CouchmobileUNSW/couchmobile-electrical/couchmobile-control/rev1/14686-Qwiic_VR_IMU_BN0080-02.jpg

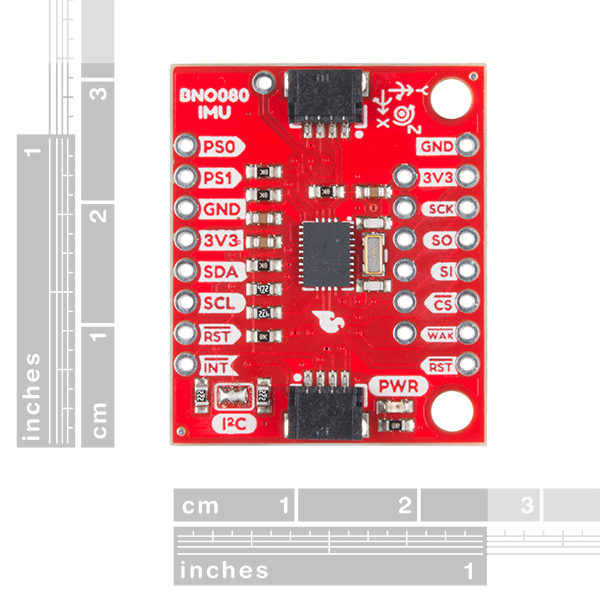
couchmobile-control/rev1/14686-Qwiic_VR_IMU_BN0080-02.jpg
