CouchmobileUNSW/couchmobile-electrical/couchmobile-control/rev1/README.md

TODO for Rev1:

Changes:
MISO, MOSI, SCK need to be made 5V tolerant, or removed
BNO080 footprint needs to be widened by 2.54mm
Traces under RF module should be adjusted slightly so they spend less time under the RF module
Resistor and LED designators for status LEDs should be swapped around in position; ie the LED designator should be facing towards the outside
SO-8 footprint needs to be made smaller
HC74 DIP 14 needs to be made bigger
E_ON should be inverted signal of the signal sent to the HC74 AND gate
