CouchmobileUNSW/couchmobile-electrical/couchmobile-old-couch/couch-int-rc.csv.xlsx

Qty | Value | Device | Package | Parts | Description | Source
1 |  | DIODE-SMB | SMB | D1 | DIODE | w
1 |  | L-USL3216C | 1206 | FB1 | INDUCTOR, American symbol | d
4 |  | LEDCHIP-LED0603 | CHIP-LED0603 | LED6, LED7, LED8, LED9 | LED | w
4 |  | MA02-1 | MOLEX-2 | J2, J20, J21, J22 |  | w
8 |  | MA03-1 | MA03-1 | J6, J9, J10, J11, J24, J25, J26, J27 | PIN HEADER | w
1 |  | MA05-1 | MA05-1 | J8 | PIN HEADER | w
1 | 1.5k | R-US_R0603 | R0603 | R6 | RESISTOR, American symbol | w
14 | 100nF | C-EUC0603 | C0603 | C3, C5, C8, C10, C11, C12, C13, C14, C19, C20, C21, C22, C23, C24 | CAPACITOR, European symbol | w
3 | 10k | R-US_R0603 | R0603 | R2, R66, R67 | RESISTOR, American symbol | w
1 | 10uF | C-EUC0603 | C0603 | C16 | CAPACITOR, European symbol | w
2 | 10uF | C-EUC1206 | C1206 | C9, C30 | CAPACITOR, European symbol | w
1 | 1296-T10 | 1296-T10 | 1296-10 | J18 | 1.27mm SINGLE ROW FEMALE SOCKET | w
1 | 12V rail | LEDCHIPLED_0603 | CHIPLED_0603 | LED4 | LED | w
4 | 150 | R-US_R0603 | R0603 | R18, R33, R40, R54 | RESISTOR, American symbol | w
1 | 15V | ZENER-DIODESOD80C | SOD80C | D2 | Z-Diode | d
2 | 18pF | C-EUC0603 | C0603 | C17, C18 | CAPACITOR, European symbol | w
1 | 1A | SHK20L | SHK20L | F3 | FUSE HOLDER 5 x 20 mm, SH contact, SHH1 Schukat, E1073 Buerklin | w
1 | 1nF | C-EUC0603 | C0603 | C34 | CAPACITOR, European symbol | w
3 | 1uF | C-EUC0603 | C0603 | C1, C2, C25 | CAPACITOR, European symbol | w
5 | 22uF | C-EUC1206 | C1206 | C4, C6, C7, C28, C29 | CAPACITOR, European symbol | w
1 | 25MHz | CRYSTALHC49S | HC49/S | X1 | CRYSTAL | w
1 | 27k | R-US_R0603 | R0603 | R7 | RESISTOR, American symbol | w
1 | 2A | FUSESHK20L | SHK20L | F1 | Fuse | w
1 | 2k | R-US_R0603 | R0603 | R13 | RESISTOR, American symbol | w
1 | 3.3V rail | LEDCHIPLED_0603 | CHIPLED_0603 | LED2 | LED | w
1 | 3.3k | R-US_R0603 | R0603 | R8 | RESISTOR, American symbol | w
2 | 330 | R-US_R0603 | R0603 | R11, R12 | RESISTOR, American symbol | w
1 | 33k | R-US_R0603 | R0603 | R9 | RESISTOR, American symbol | w
6 | 4.7k | R-US_R0603 | R0603 | R22, R25, R27, R39, R44, R50 | RESISTOR, American symbol | w
28 | 470 | R-US_R0603 | R0603 | R19, R20, R21, R23, R24, R26, R28, R34, R35, R36, R38, R41, R42, R46, R47, R48, R49, R55, R56, R57, R58, R59, R60, R61, R62, R63, R64, R65 | RESISTOR, American symbol | w
4 | 49.9 | R-US_R0603 | R0603 | R14, R15, R16, R17 | RESISTOR, American symbol | w
1 | 5.6V | ZENER-DIODESOD80C | SOD80C | D3 | Z-Diode | d
2 | 5.6k | R-US_R0603 | R0603 | R4, R68 | RESISTOR, American symbol | w
1 | 500mA | SHK20L | SHK20L | F2 | FUSE HOLDER 5 x 20 mm, SH contact, SHH1 Schukat, E1073 Buerklin | w
1 | 56k | R-US_R0603 | R0603 | R1 | RESISTOR, American symbol | w
1 | 5V rail | LEDCHIPLED_0603 | CHIPLED_0603 | LED3 | LED | w
1 | 6.8k | R-US_R0603 | R0603 | R10 | RESISTOR, American symbol | w
3 | 680 | R-US_R0603 | R0603 | R5, R37, R43 | RESISTOR, American symbol | w
4 | 75 | R-US_R0603 | R0603 | R29, R30, R31, R32 | RESISTOR, American symbol | w
1 | 82k | R-US_R0603 | R0603 | R3 | RESISTOR, American symbol | w
1 | ASE | ASE | ASE | XO1 | 3.3Vdc CMOS SMD CRYSTAL CLOCK OSCILLATOR | d
1 | BSS123 | BSS123 | SOT23 | Q1 | N-CHANNEL MOS FET | w
1 | BU-SMA-V | BU-SMA-V | BU-SMA-V | J12 | FEMALE SMA CONNECTOR | w
1 | DMP3099L | BSS84 | SOT23 | Q2 | P-CHANNEL MOS FET | d
1 | ENC28J60SS | ENC28J60SS | SSOP-28 | IC5 |  | d
2 | ESD4TPD4F003 | ESD4TPD4F003 | WSON-8 | E1, E2 |  | d
1 | ESTOP | LEDCHIPLED_0603 | CHIPLED_0603 | LED1 | LED | w
1 | Farnell 1864471 (TODO check) | L_USMCSDRH73B | MCSDRH73B | L1 |  | w
1 | LD117AS33TR | LD117AS33TR | SOT223 | IC1 | Low drop fixed and adjustable positive voltage regulators 1 A | w
1 | MA03-1KK | MA03-1KK | MOLEX-3 | J3 |  | w
4 | MA05-1 | MA05-1 | MOLEX-5 | J14, J15, J16, J17 |  | d
1 | Motor power | LEDCHIPLED_0603 | CHIPLED_0603 | LED5 | LED | w
1 | PCBTERM2 | PCBTERM2 | PCBTERM | J4 |  | w
1 | PCBTERM3 | PCBTERM3 | PCBTERM3 | J1 |  | w
1 | PIC32MK0512MCF064 | PIC32MK0512MCF064 | TQFP-64-10 | IC3 |  | d
1 | PIN262409-1 | PIN262409-1 | 62409-1 | J5 | Flachstecker Typ Tyco/Electronics/AMP TAB, FASTON | w
4 | PTC4.7 | R-EU_R0603 | R0603 | R45, R51, R52, R53 | RESISTOR, European symbol | d
1 | RF-LORA-PD | RF-LORA-PD | RF-LORA-DIP | U1 |  | f
1 | RJ45-6L-B | RJ45-6L-B | RJ45-NO-SHIELD | J7 | CORCOM Modular RJ Jacks No Shield | f
1 | TG110-E055N5 | TG110-E055N5 | N5 | T1 | E-Ultra (TM) 10/100BASE-TX SOIC-16 Fast Ethernet Magnetic Modules | f
1 | TPS563209 | TPS563209 | SOT23-6 | IC2 |  | w
1 | USB-MICROB1051330001 | USB-MICROB1051330001 | 1051330001 | J13 |  | d
