CouchmobileUNSW/couchmobile-electrical/couchmobile-old-couch/couch-int-rc-brd.pdf

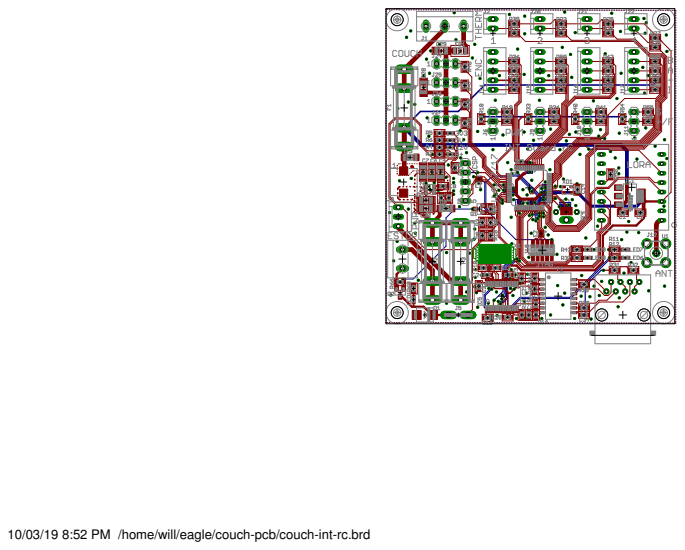
[picture p4: page 1]

10/03/19 8:52 PM /home/will/eagle/couch-pcb/couch-int-rc.brd
