CouchmobileUNSW/couchmobile-electrical/couchmobile-old-couch/couch-int-rc-sch.pdf

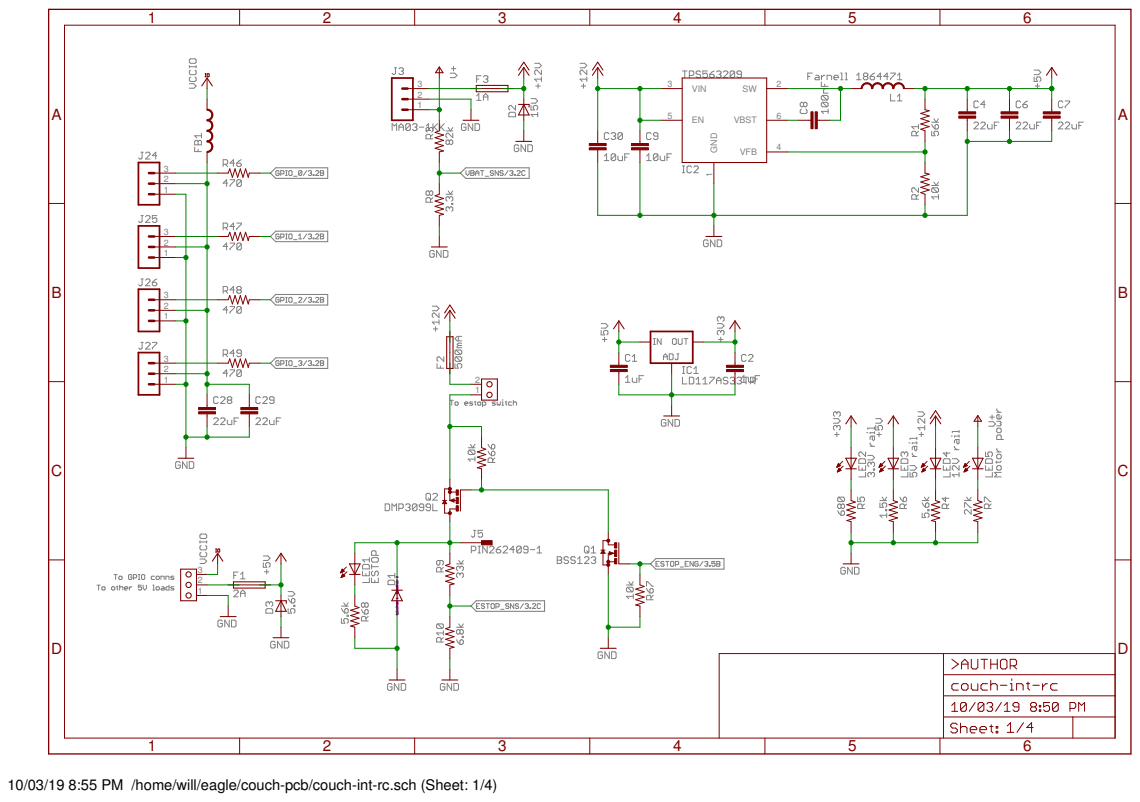
[picture p5: page 1]

10/03/19 8:55 PM /home/will/eagle/couch-pcb/couch-int-rc.sch (Sheet: 1/4)
