CouchmobileUNSW/couchmobile-electrical/couchmobile-old-couch/couch-pwr-rb-brd.pdf

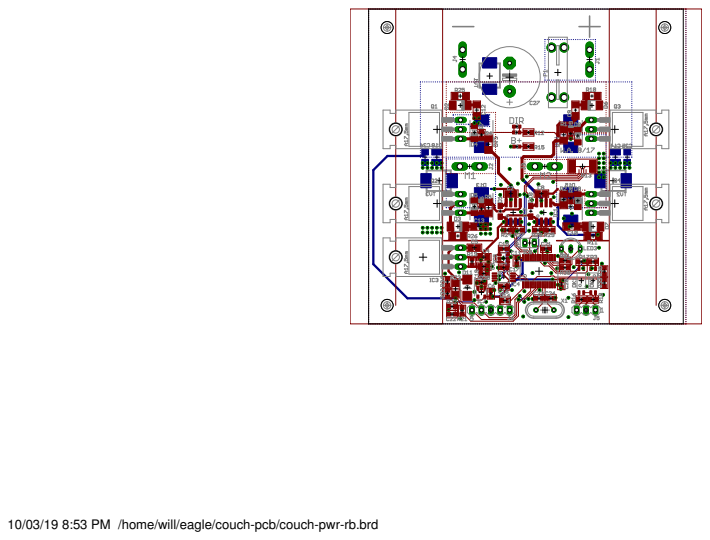
[picture p6: page 1]

10/03/19 8:53 PM /home/will/eagle/couch-pcb/couch-pwr-rb.brd
