CouchmobileUNSW/couchmobile-electrical/couchmobile-old-couch/couch-pwr-rb-sch.pdf

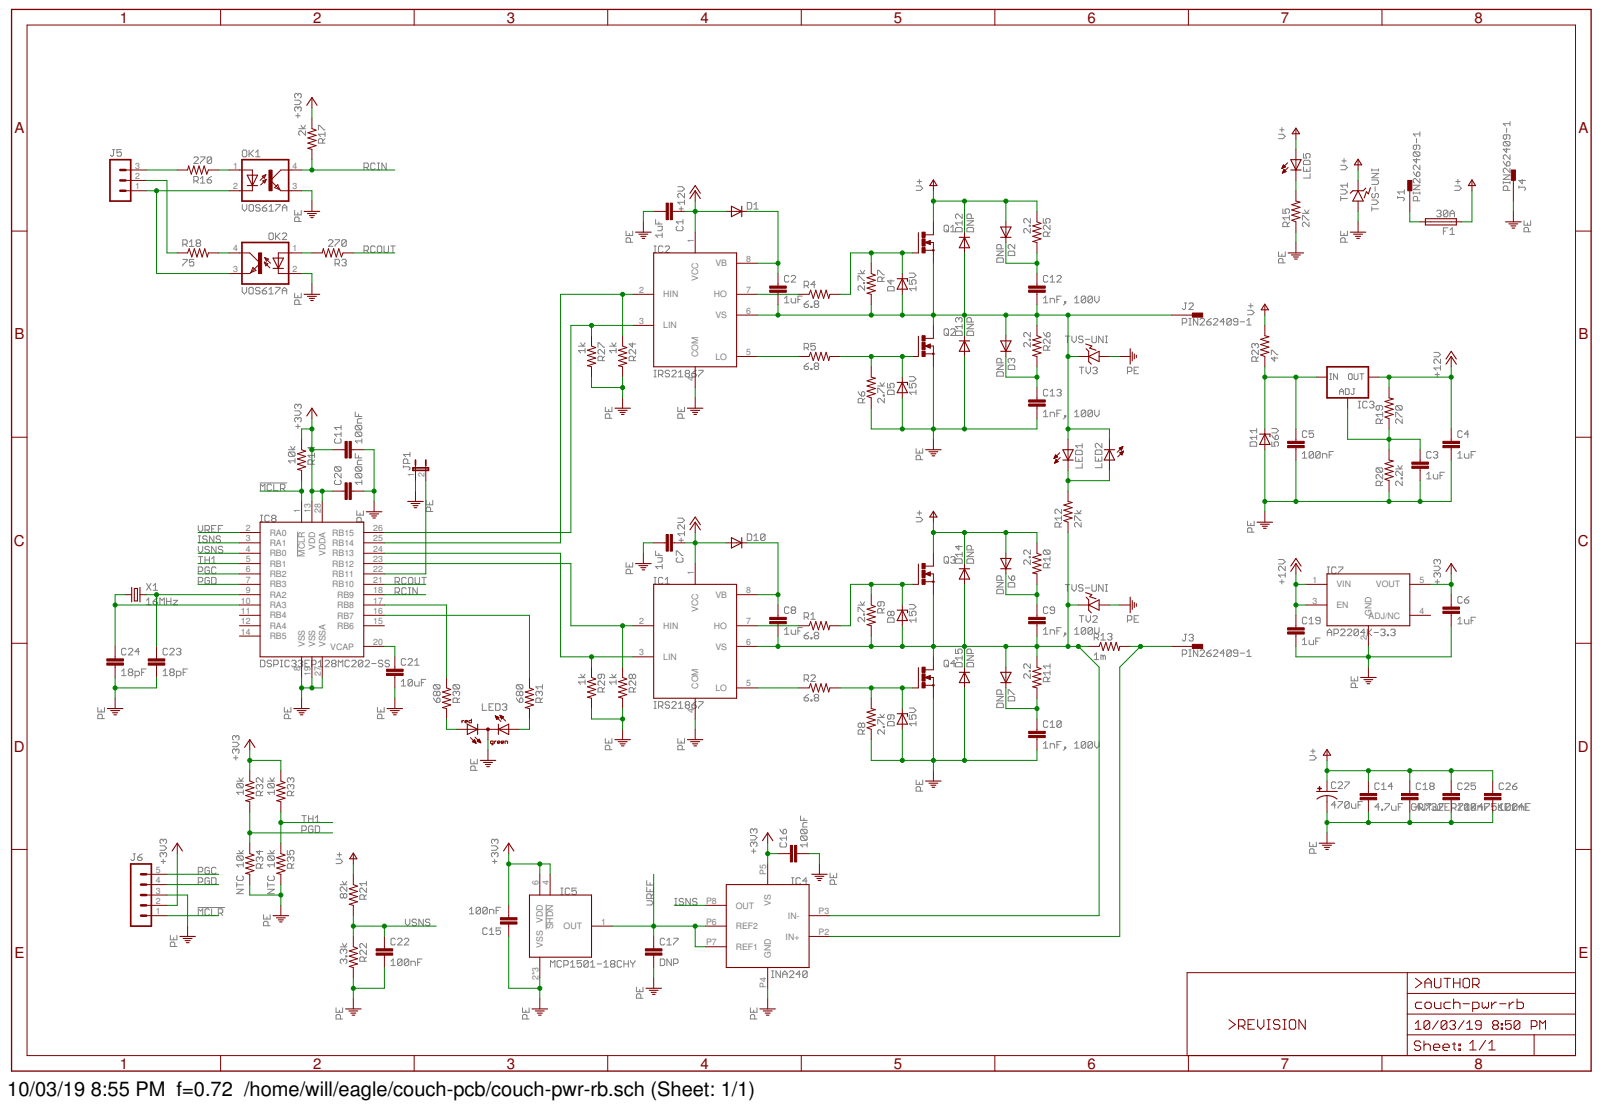
[picture p7: page 1]

10/03/19 8:55 PM f=0.72 /home/will/eagle/couch-pcb/couch-pwr-rb.sch (Sheet: 1/1)
