CouchmobileUNSW/couchmobile-electrical/control pad/control pad.kicad_pcb

## KiCad design control pad/control pad.kicad_pcb (2019-08-29)

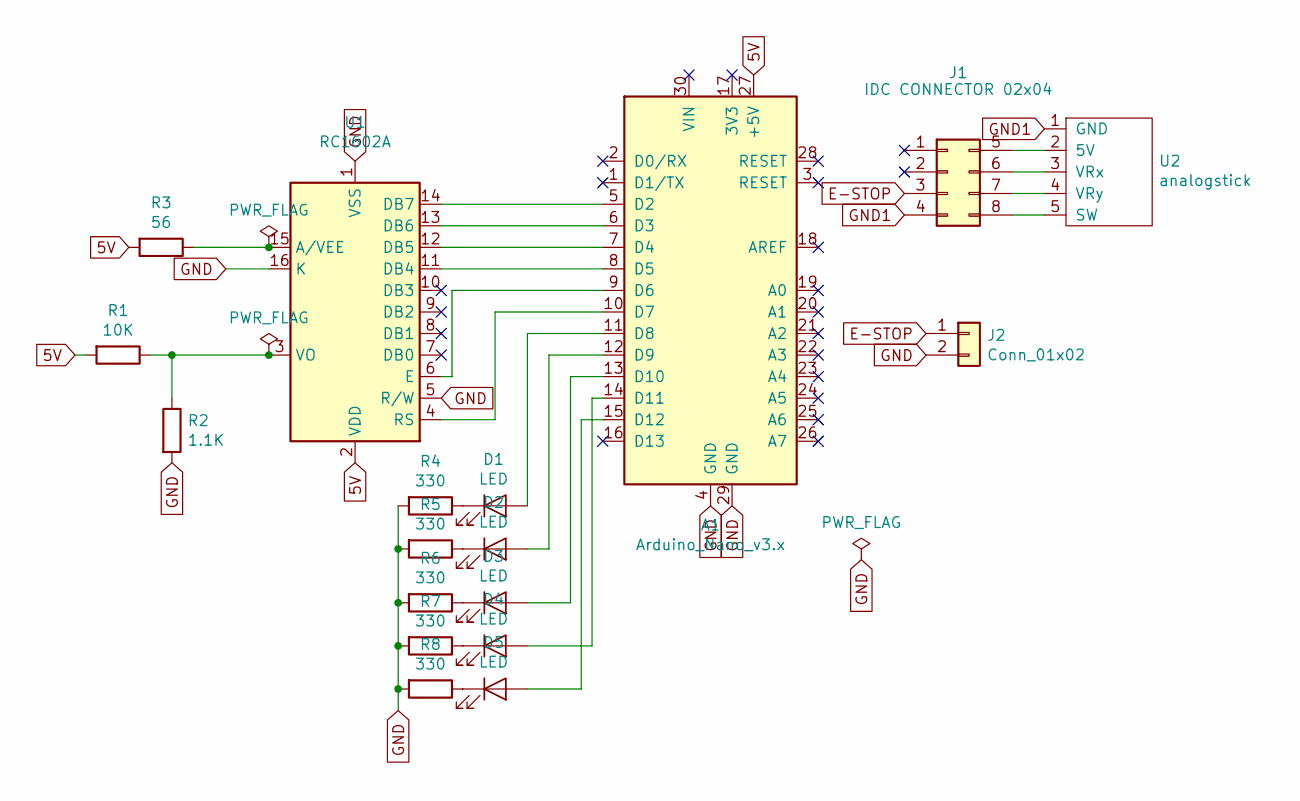
[picture p8: schematic control pad.sch]

Parts:
A1: Arduino_Nano_v3.x; Arduino_Nano_WithMountingHoles
D1, D2, D3, D4, D5: LED; D_0805_2012Metric_Pad1.15x1.40mm_HandSolder
J1: IDC CONNECTOR 02x04; IDC-Header_2x04_P2.54mm_Vertical
J2: Conn_01x02; PinHeader_1x02_P2.54mm_Vertical
R1: 10K; R_0805_2012Metric_Pad1.15x1.40mm_HandSolder
R2: 1.1K; R_0805_2012Metric_Pad1.15x1.40mm_HandSolder
R3: 56; R_0805_2012Metric_Pad1.15x1.40mm_HandSolder
R4, R5, R6, R7, R8: 330; R_0805_2012Metric_Pad1.15x1.40mm_HandSolder
U1: RC1602A; WC1602A
U2: analogstick; PinHeader_1x05_P2.54mm_Vertical

Connections:
5V: A1.27 (+5V), R1.2, R3.2, U1.2 (VDD)
E-STOP: J1.3, J2.1
GND: A1.4 (GND), A1.29 (GND), J2.2, R2.2, R4.2, R5.2, R6.2, R7.2, R8.2, U1.1 (VSS), U1.5 (R/W), U1.16 (K)
GND1: J1.4, U2.1 (GND)
unnamed: A1.5 (D2), U1.14 (DB7)
unnamed: A1.6 (D3), U1.13 (DB6)
unnamed: A1.7 (D4), U1.12 (DB5)
unnamed: A1.8 (D5), U1.11 (DB4)
unnamed: A1.9 (D6), U1.6 (E)
unnamed: A1.10 (D7), U1.4 (RS)
unnamed: A1.11 (D8), D1.2 (A)
unnamed: A1.12 (D9), D2.2 (A)
unnamed: A1.13 (D10), D3.2 (A)
unnamed: A1.14 (D11), D4.2 (A)
unnamed: A1.15 (D12), D5.2 (A)
unnamed: D1.1 (K), R4.1
unnamed: D2.1 (K), R5.1
unnamed: D3.1 (K), R6.1
unnamed: D4.1 (K), R7.1
unnamed: D5.1 (K), R8.1
unnamed: J1.5, U2.2 (5V)
unnamed: J1.6, U2.3 (VRx)
unnamed: J1.7, U2.4 (VRy)
unnamed: J1.8, U2.5 (SW)
unnamed: R1.1, R2.1, U1.3 (VO)
unnamed: R3.1, U1.15 (A/VEE)

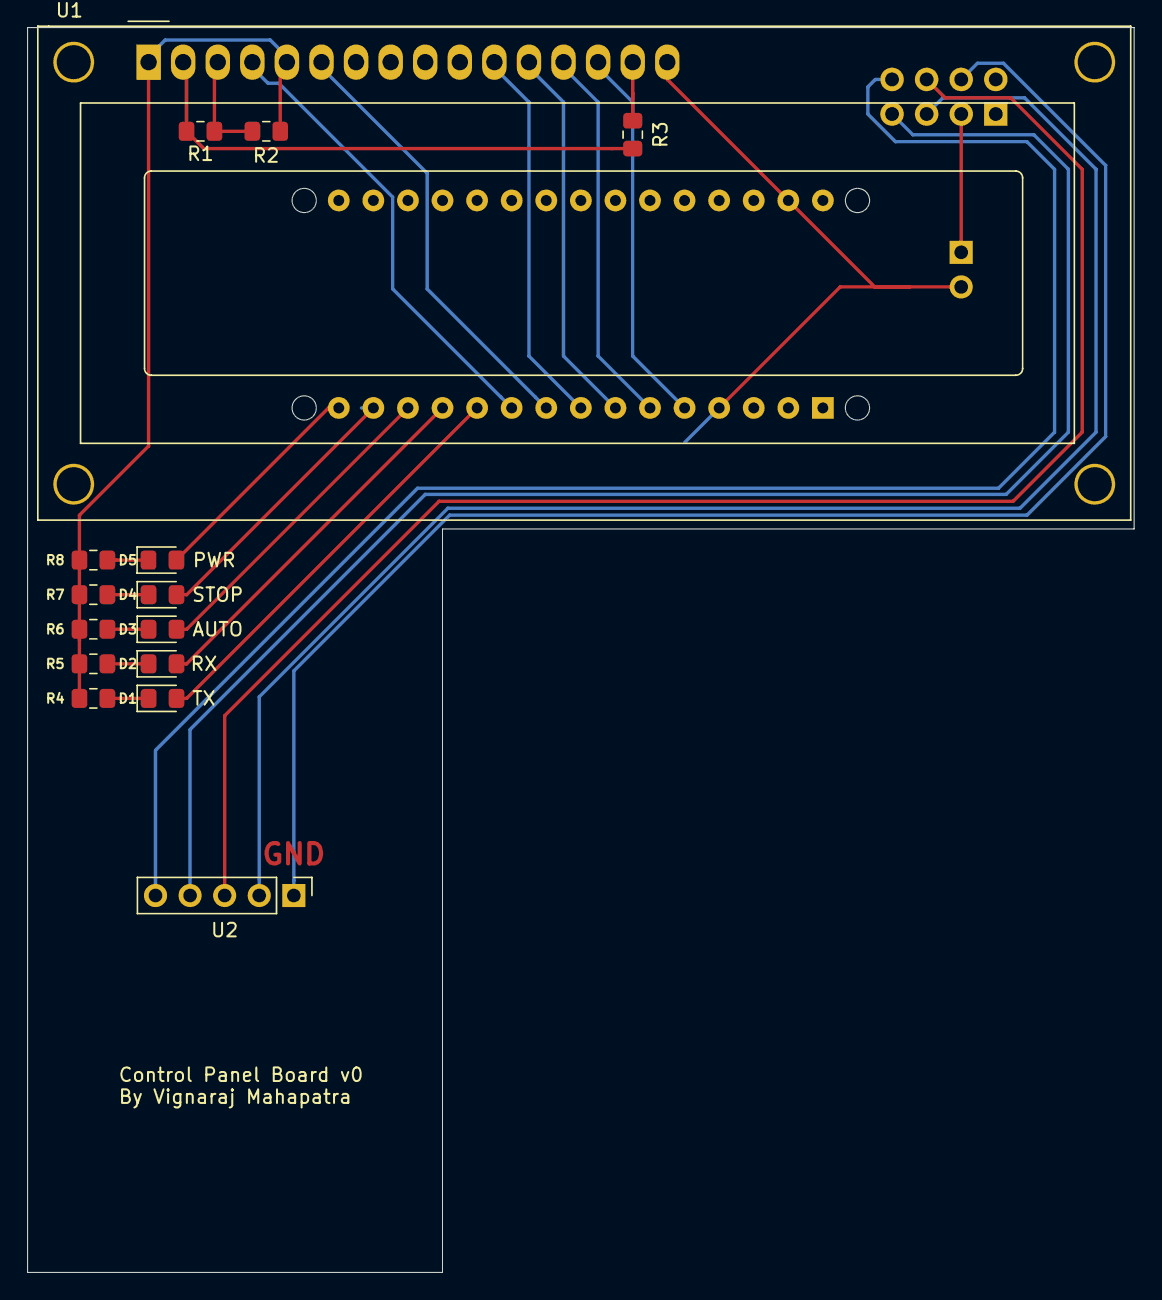
[picture p9: board control pad.kicad_pcb from above]

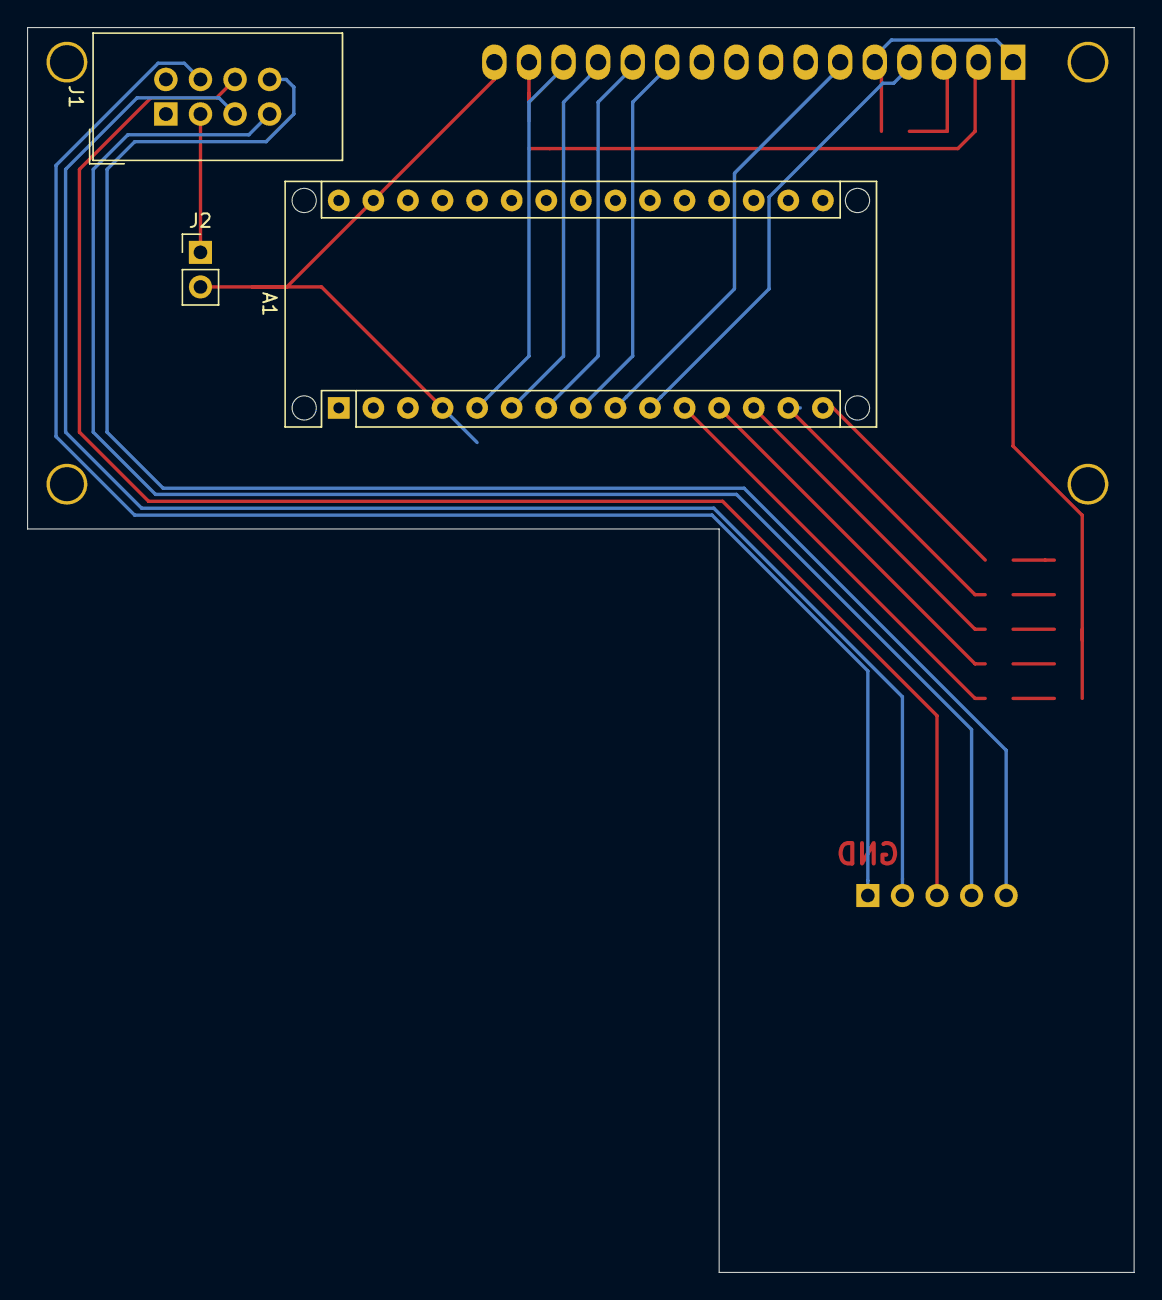
[picture p10: board control pad.kicad_pcb from below]

Board: 2 copper layers, 81.3 x 91.4 mm, 18 parts (3 on the bottom side), 26 nets.
