CouchmobileUNSW/couchmobile-electrical/couchmobile-control/rev1/couchmobile-electrical.kicad_pcb

## KiCad design couchmobile-control/rev1/couchmobile-electrical.kicad_pcb (2019-08-26)

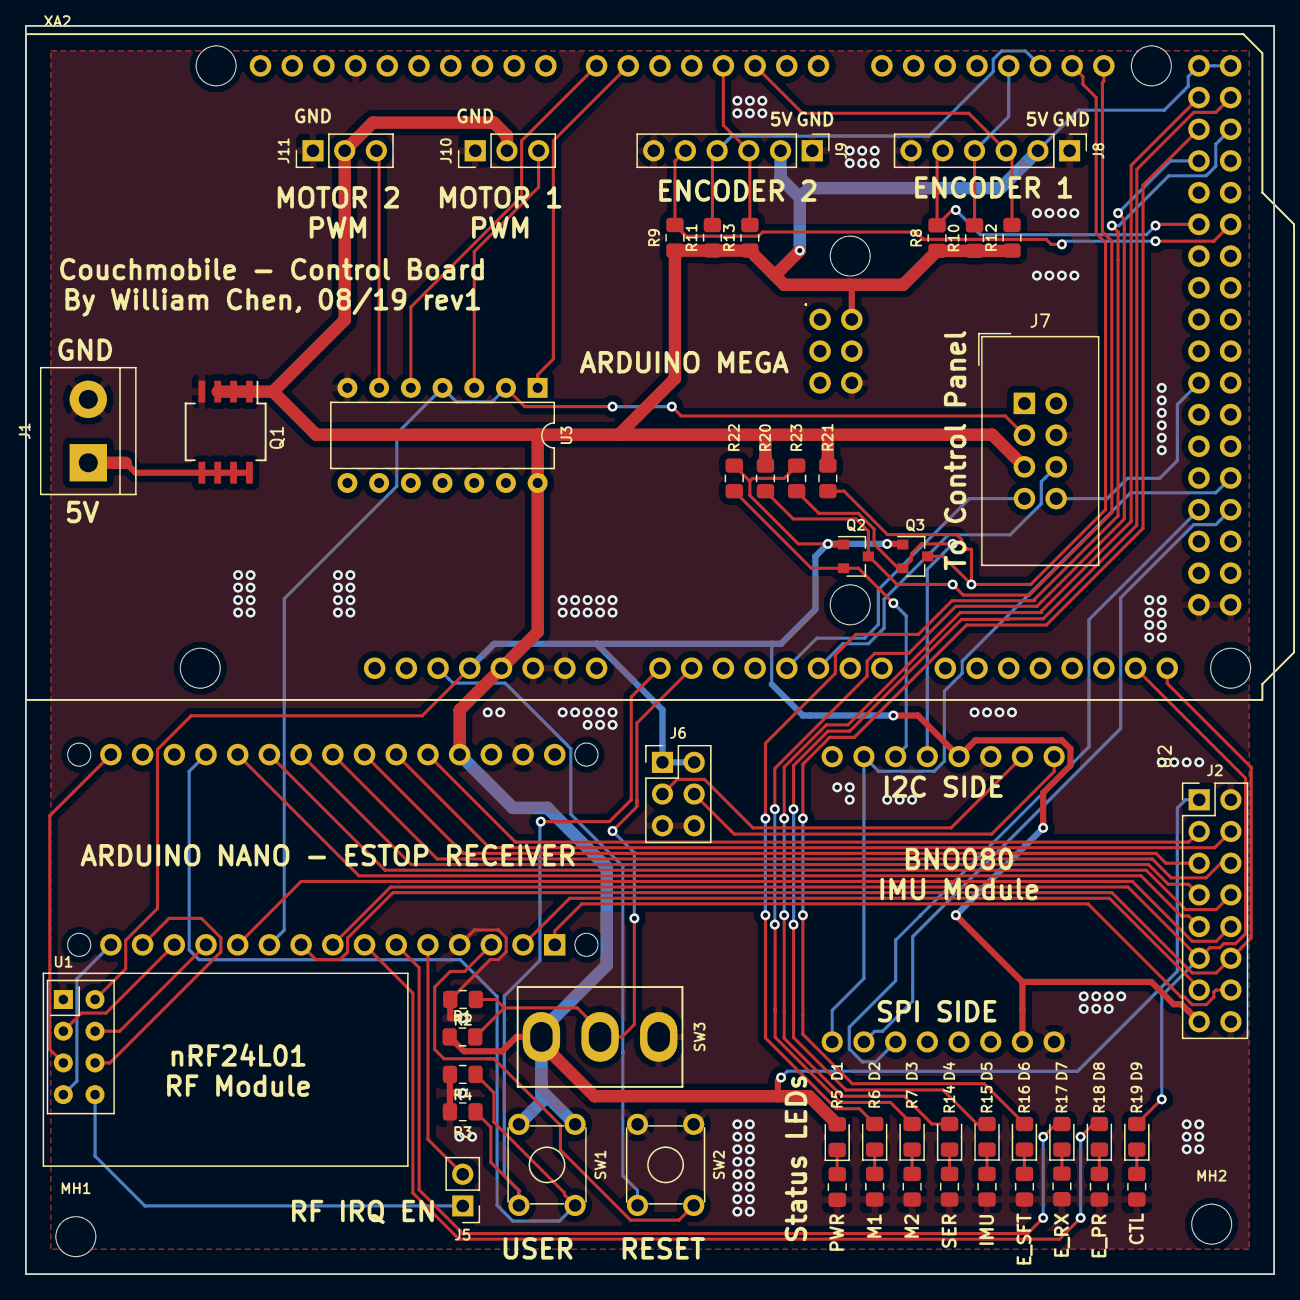
[picture p11: board couchmobile-electrical.kicad_pcb from above]

Board: 2 copper layers, 100.0 x 100.0 mm, 54 parts (1 on the bottom side), 67 nets.

Parts:
D1: STATUS_PWR; LED_0805_2012Metric_Pad1.15x1.40mm_HandSolder
D2: STATUS_M1; LED_0805_2012Metric_Pad1.15x1.40mm_HandSolder
D3: STATUS_M2; LED_0805_2012Metric_Pad1.15x1.40mm_HandSolder
D4: STATUS_SERIAL; LED_0805_2012Metric_Pad1.15x1.40mm_HandSolder
D5: STATUS_IMU; LED_0805_2012Metric_Pad1.15x1.40mm_HandSolder
D6: STATUS_ENCODER; LED_0805_2012Metric_Pad1.15x1.40mm_HandSolder
D7: ESTOP_RX; LED_0805_2012Metric_Pad1.15x1.40mm_HandSolder
D8: ESTOP_EN; LED_0805_2012Metric_Pad1.15x1.40mm_HandSolder
D9: ESTOP_ON; LED_0805_2012Metric_Pad1.15x1.40mm_HandSolder
J1: Power_In; TerminalBlock_bornier-2_P5.08mm
J2: GPIO_NANO_1; PinHeader_2x08_P2.54mm_Vertical
J5: ESTOP_IRQ_EN; PinHeader_1x02_P2.54mm_Vertical
J6: BNO_COMM_CTRL; PinHeader_2x03_P2.54mm_Vertical
J7: Conn_02x04_Top_Bottom; IDC-Header_2x04_P2.54mm_Vertical
J8: Encoder1; PinHeader_1x06_P2.54mm_Vertical
J9: Encoder2; PinHeader_1x06_P2.54mm_Vertical
J10: Motor1; PinHeader_1x03_P2.54mm_Vertical
J11: Motor2; PinHeader_1x03_P2.54mm_Vertical
MH1, MH2: MountingHole; MountingHole_3.2mm_M3_ISO7380
Q1: PMOS DGS; SO-8_DGS
Q2, Q3: BSS138; SOT-23
R1, R2, R3, R4, R20, R21, R22, R23: 10k; R_0805_2012Metric_Pad1.15x1.40mm_HandSolder
R5, R6, R7, R8, R9, R10, R11, R12, R13, R14, R15, R16, R17, R18, R19: 2.2k; R_0805_2012Metric_Pad1.15x1.40mm_HandSolder
SW1: User Button; SW_TH_Tactile_Omron_B3F-10xx
SW2: RESET; SW_TH_Tactile_Omron_B3F-10xx
SW3: User Switch; MTS_3_pin_toggle_switch
U1: NRF24L01_Breakout; nRF24L01_Breakout
U2: BNO080
U3: 74LS08; DIP-14_W7.62mm
XA1: Arduino_Nano_Socket
XA2: Arduino_Mega2560_Shield

Connections:
+3V3: J2.15, J6.1, J6.2, Q2.1, Q3.1, R22.2, R23.2, U1.2, U2.3, U2.9, XA2.3V3
+5V: D1.2, J2.1, J7.5, J8.2, J9.2, J10.2, J11.2, Q1.3, R1.1, R8.1, R9.1, R10.1, R11.1, R12.1, R13.1, R20.1, R21.1, SW1.1, SW1.3, SW3.3, U3.14, XA1.5V, XA2.5V1, XA2.5V2, XA2.5V3, XA2.5V4
/EN1_1: J8.3, R12.2, XA2.D2
/EN1_2: J8.4, R10.2, XA2.D18
/EN1_3: J8.5, R8.2, XA2.D30
/EN2_1: J9.3, R13.2, XA2.D3
/EN2_2: J9.4, R11.2, XA2.D19
/EN2_3: J9.5, R9.2, XA2.D31
/ESTOP_CE: U1.3, XA1.D10
/ESTOP_CSN: U1.4, XA1.D9
/ESTOP_EN: D8.2, XA1.D4
/ESTOP_HS: J2.12, XA1.D6, XA2.A15
/ESTOP_IRQ: J5.1, U1.8
/ESTOP_MISO: U1.7, XA1.D12
/ESTOP_MOSI: U1.6, XA1.D11
/ESTOP_ON: D9.2, J2.11, XA1.D5, XA2.A14
/ESTOP_RX: D7.2, XA1.D3
/ESTOP_SCK: U1.5, XA1.D13
/ESTOP_TRAN: J7.3, U3.2, U3.4, XA1.D7
/IMU_CS: U2.13, XA2.D48
/IMU_RESET: U2.6, U2.15, XA2.D47
/IMU_WAKE: U2.14, XA2.D49
/JOYSTICK_SW: J7.8, XA2.D40
/JOYSTICK_X: J7.6, XA2.A5
/JOYSTICK_Y: J7.7, XA2.A4
/M1_OUT: J10.3, U3.3
/M2_OUT: J11.3, U3.6
/MEGA_RESET: SW2.4, XA2.RST1
/MEGA_SW1: R3.1, SW1.4, XA2.A0
/MEGA_SW2: R1.2, R2.1, SW3.2, XA2.A1
/NANO_A1: J2.9, XA1.A1
/NANO_A2: J2.8, XA1.A2
/NANO_A3: J2.7, XA1.A3
/NANO_A4: J2.6, XA1.A4
/NANO_A5: J2.5, XA1.A5
/NANO_A6: J2.4, XA1.A6
/NANO_A7: J2.3, XA1.A7
/NANO_D8: J2.10, XA1.D8
/NANO_INT0: J5.2, XA1.D2
/NANO_RESET: SW2.2, XA1.RST1
/NANO_RX: J2.13, XA1.D0
/NANO_SW1: R4.1, SW1.2, XA1.A0
/NANO_TX: J2.14, XA1.D1
/PWM_M1: U3.1, XA2.D6
/PWM_M2: U3.5, XA2.D7
/SCL: Q2.3, R20.2, XA2.D21
/SCL_3V3: Q2.2, R22.1, U2.5
/SDA: Q3.3, R21.2, XA2.D20
/SDA_3V3: Q3.2, R23.1, U2.4
/STATUS_ENC: D6.2, XA2.D24
/STATUS_IMU: D5.2, XA2.D23
/STATUS_M1: D2.2, XA2.D25
/STATUS_M2: D3.2, XA2.D26
/STATUS_SERIAL: D4.2, XA2.D22
GND: J1.2, J2.2, J2.16, J6.5, J6.6, J7.4, J8.1, J8.6, J9.1, J9.6, J10.1, J11.1, Q1.2, R2.2, R3.2, R4.2, R5.2, R6.2, R7.2, R14.2, R15.2, R16.2, R17.2, R18.2, R19.2, SW2.1, SW2.3, SW3.1, U1.1, U2.2, U2.8, U3.7, XA1.GND1, XA1.GND2, XA2.GND1, XA2.GND2, XA2.GND3, XA2.GND4, XA2.GND5, XA2.GND6
unnamed: D1.1, R5.1
unnamed: D2.1, R6.1
unnamed: D3.1, R7.1
unnamed: D4.1, R14.1
unnamed: D5.1, R15.1
unnamed: D6.1, R16.1
unnamed: D7.1, R17.1
unnamed: D8.1, R18.1
unnamed: D9.1, R19.1
unnamed: J1.1, Q1.1
unnamed: J6.3, U2.1
unnamed: J6.4, U2.0
