CouchmobileUNSW/couchmobile-electrical/couchmobile-old-couch/couch-pwr-rb/couch-pwr-rb.kicad_pcb

## KiCad design couchmobile-old-couch/couch-pwr-rb/couch-pwr-rb.kicad_pcb (2019-08-26, an earlier design)

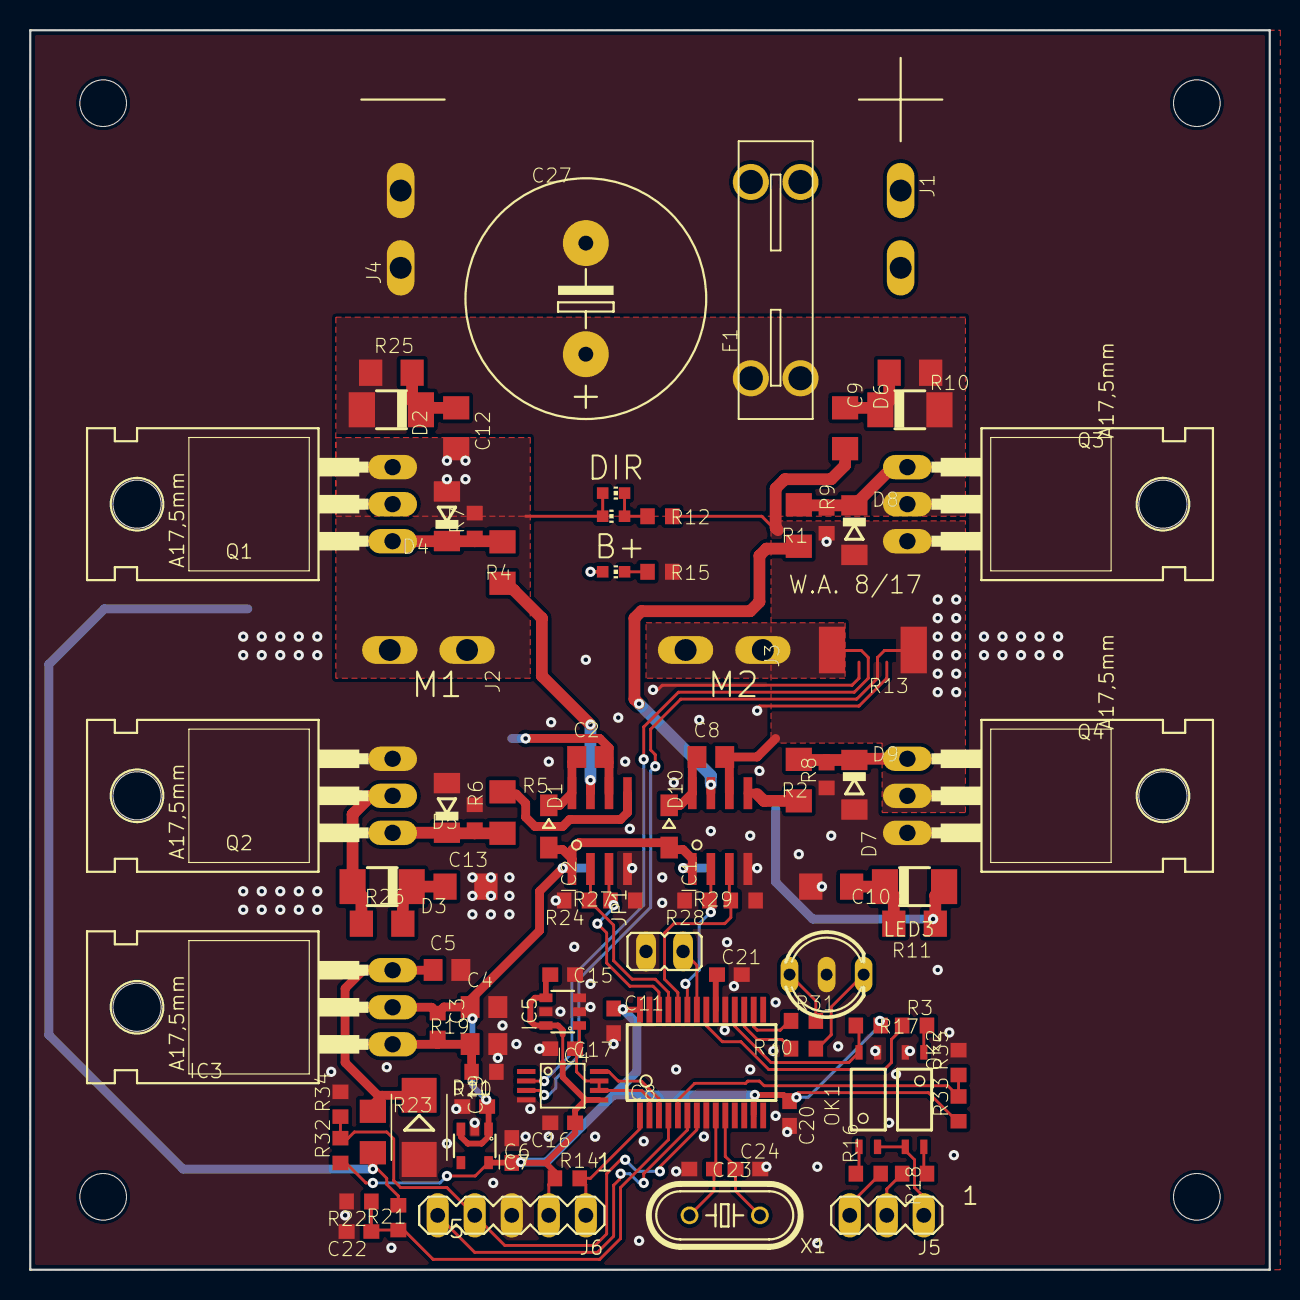
[picture p13: board couch-pwr-rb.kicad_pcb from above]

Board: 2 copper layers, 85.0 x 85.0 mm, 110 parts (0 on the bottom side), 53 nets.

Parts:
@HOLE0, @HOLE1, @HOLE2, @HOLE3: (no value)
C1, C2, C3, C4, C7, C8: 1uF; C0805
C5: 100nF; C0805
C6, C19: 1uF; C0603
C9, C10, C12, C13: 1nF, 100V; C1206
C11, C15, C16, C20, C22: 100nF; C0603
C14: 4.7uF GRM32ER71K475KE14L; C1210
C17: DNP; C0603
C18: 4.7uF; C1210
C21: 10uF; C0603
C23, C24: 18pF; C0603
C25, C26: 100nF; C1206
C27: 470uF; E7,5-16
D1, D10: DIODE-SOD323-W; SOD323-W
D2, D3, D6, D7: DNP; DO-214AC
D4, D5, D8, D9: 15V; SOD80C
D11: 56V; SMB
D12, D13, D14, D15: DNP; SMC
F1: 30A; BLADEFUSE
IC1, IC2: IRS21867; SO-08
IC3: LM317TLBH; TO220BH
IC4: INA240; VSSOP-8
IC5: MCP1501-CHY; SOT23-6
IC7: AP2204K-3.3; SOT23-5
IC8: DSPIC33EPMC202-SS; SSOP-28
J1, J2, J3, J4: PIN262409-1; 62409-1
J5: MA03-1
J6: MA05-1
JP1: JP1E; JP1
LED1, LED2, LED5: LEDCHIP-LED0603; CHIP-LED0603
LED3: DUOLED-RG-C; DUOLED-C-5MM
OK1, OK2: VOS617A; MINI-FLAT-4
Q1, Q2, Q3, Q4: PMOSFET_NTO220BH; TO220BH
R1, R2, R4, R5: 6.8; R1206
R3, R16, R19: 270; R0603
R6, R7, R8, R9: 2.7k; R0603
R10, R11, R25, R26: 2.2; R1206
R12, R15: 27k; R0603
R13: 1m; R2512
R14, R32, R33: 10k; R0603
R17: 2k; R0603
R18: 75; R0603
R20: 2.2k; R0603
R21: 82k; R0603
R22: 3.3k; R0603
R23: 47; R1206
R24, R27, R28, R29: 1k; R0603
R30, R31: 680; R0603
R34, R35: NTC 10k; R0603
TV1, TV2, TV3: TVS-UNI; SMC
X1: 16MHz; HC49_S

Connections:
+3V3: C6.1, C11.1, C15.2, C16.1, C20.1, IC4.P5, IC5.4, IC5.6, IC7.5, IC8.13, IC8.28, J6.2, R14.1, R17.1, R32.1, R33.1
+12V: C1.1, C4.1, C7.1, C19.1, D1.A, D10.A, IC1.1, IC2.1, IC3.D, IC7.1, IC7.3, R19.2
/ISNS: IC4.P8, IC8.3
/PGC: IC8.6, J6.5
/PGD: IC8.7, J6.4, R32.2, R34.1
/RCIN: IC8.18, OK1.4, R17.2
/RCOUT: IC8.21, R3.1
/TH1: IC8.5, R33.2, R35.1
/VREF: C17.1, IC4.P6, IC4.P7, IC5.1, IC8.2
/VSNS: C22.1, IC8.4, R21.2, R22.1
/~MCLR: IC8.1, J6.1, R14.2
unnamed: C2.1, D1.C, IC2.8
unnamed: C3.1, IC3.G, R19.1, R20.2
unnamed: C5.1, D11.C, IC3.S, R23.1
unnamed: C8.1, D10.C, IC1.8
unnamed: C8.2, C9.2, D7.A, D8.A, D14.A, D15.C, IC1.6, IC4.P3, Q3.S, Q4.D, R9.2, R11.1, R12.1, R13.1, TV2.1
unnamed: C9.1, D6.C, R10.2
unnamed: C10.1, D7.C, R11.2
unnamed: C12.1, D2.C, R25.2
unnamed: C2.2, C12.2, D3.A, D4.A, D12.A, D13.C, IC2.6, J2.A1, J2.A2, LED1.A, LED2.C, Q1.S, Q2.D, R7.2, R26.1, TV3.1
unnamed: C13.1, D3.C, R26.2
unnamed: C21.1, IC8.20
unnamed: C23.1, IC8.9, X1.2
unnamed: C24.1, IC8.10, X1.1
unnamed: D4.C, Q1.G, R4.2, R7.1
unnamed: D5.C, Q2.G, R5.2, R6.2
unnamed: D8.C, Q3.G, R1.2, R9.1
unnamed: D9.C, Q4.G, R2.2, R8.2
unnamed: F1.2A, F1.2B, J1.A1, J1.A2
unnamed: IC1.2, IC8.23, R28.1
unnamed: IC1.3, IC8.24, R29.1
unnamed: IC1.5, R2.1
unnamed: IC1.7, R1.1
unnamed: IC2.2, IC8.25, R24.1
unnamed: IC2.3, IC8.26, R27.1
unnamed: IC2.5, R5.1
unnamed: IC2.7, R4.1
unnamed: IC4.P2, J3.A1, J3.A2, R13.2
unnamed: IC8.16, R31.1
unnamed: IC8.17, R30.1
unnamed: IC8.22, JP1.2
unnamed: J5.1, OK1.2, OK2.3
unnamed: J5.2, R18.1
unnamed: J5.3, R16.2
unnamed: LED1.C, LED2.A, R12.2
unnamed: LED3.AR, R30.2
unnamed: LED3.AX, R31.2
unnamed: LED5.C, R15.2
unnamed: OK1.1, R16.1
unnamed: OK2.1, R3.2
unnamed: OK2.4, R18.2
PE: C1.2, C3.2, C4.2, C5.2, C6.2, C7.2, C10.2, C11.2, C13.2, C14.2, C15.1, C16.2, C17.2, C18.2, C19.2, C20.2, C21.2, C22.2, C23.2, C24.2, C25.2, C26.2, C27.-, D5.A, D9.A, D11.A, D13.A, D15.A, IC1.4, IC2.4, IC4.P4, IC5.2, IC5.3, IC5.5, IC7.2, IC8.8, IC8.19, IC8.27, J4.A1, J4.A2, J6.3, JP1.1, LED3.C, OK1.3, OK2.2, Q2.S, Q4.S, R6.1, R8.1, R15.1, R20.1, R22.2, R24.2, R27.2, R28.2, R29.2, R34.2, R35.2, TV1.2, TV2.2, TV3.2
V+: C14.1, C18.1, C25.1, C26.1, C27.+, D2.A, D6.A, D12.C, D14.C, F1.1A, F1.1B, LED5.A, Q1.D, Q3.D, R10.1, R21.1, R23.2, R25.1, TV1.1
