CouchmobileUNSW/couchmobile-electrical/couchmobile-old-couch/couch-int-rc/couch-int-rc.kicad_pcb

## KiCad design couchmobile-old-couch/couch-int-rc/couch-int-rc.kicad_pcb (2019-08-26, an earlier design)

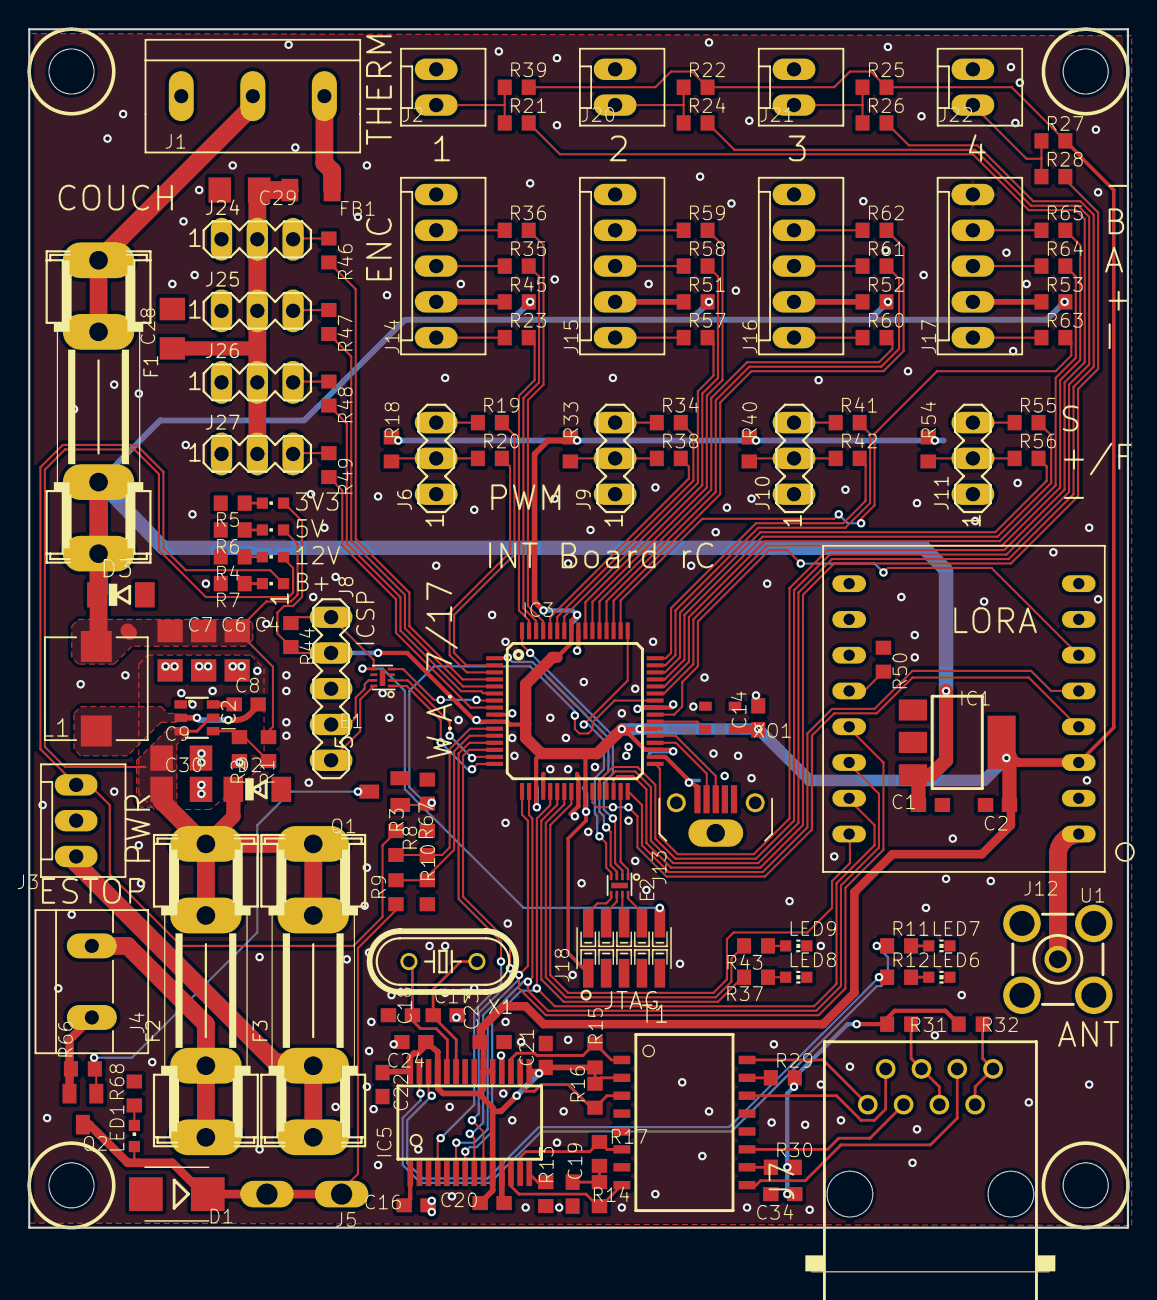
[picture p14: board couch-int-rc.kicad_pcb from above]

Board: 2 copper layers, 78.0 x 88.2 mm, 154 parts (0 on the bottom side), 131 nets.

Parts:
@HOLE0, @HOLE1, @HOLE2, @HOLE3: (no value)
C1, C2, C25: 1uF; C0603
C3, C5, C8, C10, C11, C12, C13, C14, C19, C20, C21, C22, C23, C24: 100nF; C0603
C4, C6, C7, C28, C29: 22uF; C1206
C9, C30: 10uF; C1206
C16: 10uF; C0603
C17, C18: 18pF; C0603
C34: 1nF; C0603
D1: DIODE-SMB; SMB
D2: 15V; SOD80C
D3: 5.6V; SOD80C
E1, E2: ESD4; WSON-8
F1: 2A; SHK20L
F2: 500mA; SHK20L
F3: 1A; SHK20L
FB1: L-USL3216C; L3216C
IC1: LD117A?S; SOT223
IC2: TPS56209; SOT23-6
IC3: PIC32MKMCF064; TQFP-64-10
IC5: ENC28J60SS; SSOP-28
J1: PCBTERM3
J2, J20, J21, J22: MA02-1; MOLEX-2
J3: MA03-1KK; MOLEX-3
J4: PCBTERM2; PCBTERM
J5: PIN262409-1; 62409-1
J6, J9, J10, J11, J24, J25, J26, J27: MA03-1
J7: RJ45; RJ45-NO-SHIELD
J8: MA05-1
J12: BU-SMA-V
J13: USB-MICROB1051330001; 1051330001
J14, J15, J16, J17: MA05-1; MOLEX-5
J18: 1296-T10; 1296-10
L1: Farnell 1864471; MCSDRH73B
LED1: ESTOP; CHIPLED_0603
LED2: 3.3V rail; CHIPLED_0603
LED3: 5V rail; CHIPLED_0603
LED4: 12V rail; CHIPLED_0603
LED5: Motor power; CHIPLED_0603
LED6, LED7, LED8, LED9: LEDCHIP-LED0603; CHIP-LED0603
Q1: BSS123; SOT23
Q2: DMP3099L; SOT23
R1: 56k; R0603
R2, R66, R67: 10k; R0603
R3: 82k; R0603
R4, R68: 5.6k; R0603
R5, R37, R43: 680; R0603
R6: 1.5k; R0603
R7: 27k; R0603
R8: 3.3k; R0603
R9: 33k; R0603
R10: 6.8k; R0603
R11, R12, R18, R33, R40, R54: 330; R0603
R13: 2k; R0603
R14, R15, R16, R17: 49.9; R0603
R19, R20, R21, R23, R24, R26, R28, R34, R35, R36, R38, R41, R42, R46, R47, R48, R49, R55, R56, R57, R58, R59, R60, R61, R62, R63, R64, R65: 470; R0603
R22, R25, R27, R39, R44, R50: 4.7k; R0603
R29, R30, R31, R32: 75; R0603
R45, R51, R52, R53: PTC4.7; R0603
T1: TG110-EN5; N5
U1: RF-LORA-PD; RF-LORA-DIP
X1: 25MHz; HC49_S
XO1: ASE

Connections:
+3V3: C2.1, C3.1, C5.1, C10.1, C11.1, C12.1, C13.1, C14.1, C20.1, C21.1, C22.1, C23.1, C24.1, IC1.4, IC3.10, IC3.19, IC3.26, IC3.35, IC3.38, IC3.57, IC5.10, IC5.15, IC5.19, IC5.20, IC5.25, IC5.28, J8.2, J18.1, LED2.A, R15.2, R16.2, R18.1, R22.2, R25.2, R27.2, R33.1, R39.2, R40.1, R44.2, R54.1, T1.2, U1.P$3, XO1.4
+5V: C1.1, C4.1, C6.1, C7.1, D3.C, F1.2A, F1.2B, IC1.3, L1.P$2, LED3.A, R1.2, R45.2, R51.2, R52.2, R53.2
+12V: C9.1, C30.1, D2.C, F2.2A, F2.2B, F3.2A, F3.2B, IC2.3, IC2.5, LED4.A
/couch-int-rc_3/PGC: E1.1, IC3.16
/couch-int-rc_3/PGD: E1.2, IC3.15
/couch-int-rc_3/RX_DONE: IC3.40, U1.P$6
/couch-int-rc_3/RX_SW: IC3.27, U1.P$4
/couch-int-rc_3/STAT1: IC3.22, R37.2
/couch-int-rc_3/STAT2: IC3.23, R43.2
/couch-int-rc_3/TCK: E2.3, IC3.1
/couch-int-rc_3/TCKI: E2.6, J18.4
/couch-int-rc_3/TDI: E2.1, IC3.31
/couch-int-rc_3/TDII: E2.8, J18.8
/couch-int-rc_3/TDO: E2.2, IC3.64
/couch-int-rc_3/TDOI: E2.7, J18.6
/couch-int-rc_3/TMS: E2.4, IC3.49
/couch-int-rc_3/TMSI: E2.5, J18.2
/couch-int-rc_3/TX_SW: IC3.32, U1.P$5
/couch-int-rc_3/~CS_L: IC3.24, U1.P$16
/couch-int-rc_3/~MCLR: E1.4, IC3.7
/couch-int-rc_3/~MCLRI: E1.5, J8.1, J18.10, R44.1
ESTOP_ENG: IC3.42, Q1.1, R67.1
ESTOP_SNS: IC3.12, R9.2, R10.1
GND: C1.2, C2.2, C3.2, C4.2, C5.2, C6.2, C7.2, C9.2, C10.2, C11.2, C12.2, C13.2, C14.2, C16.2, C17.2, C18.2, C19.2, C20.2, C21.2, C22.2, C23.2, C24.2, C25.2, C28.2, C29.2, C30.2, C34.2, D1.A, D2.A, D3.A, E1.9, E2.9, IC1.1, IC2.1, IC3.9, IC3.20, IC3.25, IC3.41, IC3.56, IC5.2, IC5.11, IC5.18, IC5.21, IC5.22, J1.1, J2.1, J3.2, J6.1, J8.3, J9.1, J10.1, J11.1, J12.2, J12.3, J12.4, J12.5, J13.5, J13.P$1, J13.P$2, J13.P$3, J18.3, J18.5, J18.9, J20.1, J21.1, J22.1, J24.1, J25.1, J26.1, J27.1, LED6.C, LED7.C, LED8.C, LED9.C, Q1.2, R2.1, R4.2, R5.2, R6.2, R7.2, R8.2, R10.2, R13.2, R50.1, R67.2, R68.2, U1.P$2, XO1.2
GPIO_0: IC3.4, R46.2
GPIO_1: IC3.5, R47.2
GPIO_2: IC3.6, R48.2
GPIO_3: IC3.8, R49.2
M1FB: IC3.3, R20.2
M1RC: IC3.2, R19.2
M2FB: IC3.60, R38.2
M2RC: IC3.59, R34.2
M3FB: IC3.48, R42.2
M3RC: IC3.47, R41.2
M4FB: IC3.46, R56.2
M4RC: IC3.45, R55.2
MISO: IC3.18, IC5.6, U1.P$14
MOSI: IC3.21, IC5.7, U1.P$15
unnamed: C8.1, IC2.6
unnamed: C8.2, IC2.2, L1.P$1
unnamed: C16.1, IC5.1
unnamed: C17.1, IC5.23, X1.1
unnamed: C18.1, IC5.24, X1.2
unnamed: C19.1, R14.2, R17.2
unnamed: C25.1, IC3.34, J13.1
unnamed: C28.1, C29.1, FB1.2, J24.2, J25.2, J26.2, J27.2
unnamed: C34.1, R29.2, R30.2, R31.2, R32.2
unnamed: D1.C, J5.A1, J5.A2, LED1.A, Q2.3, R9.1
unnamed: E1.7, J8.4
unnamed: E1.8, J8.5
unnamed: F1.1A, F1.1B, J1.2
unnamed: F2.1A, F2.1B, J4.2
unnamed: F3.1A, F3.1B, J3.3
unnamed: IC2.4, R1.1, R2.2
unnamed: IC3.36, J13.2
unnamed: IC3.37, J13.3
unnamed: IC3.39, XO1.3
unnamed: IC5.12, R14.1, T1.8
unnamed: IC5.13, R17.1, T1.6
unnamed: IC5.14, R13.1
unnamed: IC5.16, R16.1, T1.3
unnamed: IC5.17, R15.1, T1.1
unnamed: IC5.26, R12.1
unnamed: IC5.27, R11.1
unnamed: J2.2, R21.1, R39.1
unnamed: J4.1, Q2.2, R66.1
unnamed: J6.2, R18.2, R20.1
unnamed: J6.3, R19.1
unnamed: J7.1, T1.16
unnamed: J7.2, T1.14
unnamed: J7.3, T1.11
unnamed: J7.4, J7.5, R31.1
unnamed: J7.6, T1.9
unnamed: J7.7, J7.8, R32.1
unnamed: J9.2, R33.2, R38.1
unnamed: J9.3, R34.1
unnamed: J10.2, R40.2, R42.1
unnamed: J10.3, R41.1
unnamed: J11.2, R54.2, R56.1
unnamed: J11.3, R55.1
unnamed: J12.1, U1.P$1
unnamed: J14.4, R36.1
unnamed: J14.5, R35.1
unnamed: J15.4, R59.1
unnamed: J15.5, R58.1
unnamed: J16.4, R62.1
unnamed: J16.5, R61.1
unnamed: J17.4, R65.1
unnamed: J17.5, R64.1
unnamed: J20.2, R22.1, R24.1
unnamed: J21.2, R25.1, R26.1
unnamed: J22.2, R27.1, R28.1
unnamed: J24.3, R46.1
unnamed: J25.3, R47.1
unnamed: J26.3, R48.1
unnamed: J27.3, R49.1
unnamed: LED1.C, R68.1
unnamed: LED2.C, R5.1
unnamed: LED3.C, R6.1
unnamed: LED4.C, R4.1
unnamed: LED5.C, R7.1
unnamed: LED6.A, R12.2
unnamed: LED7.A, R11.2
unnamed: LED8.A, R37.1
unnamed: LED9.A, R43.1
unnamed: Q1.3, Q2.1, R66.2
unnamed: R29.1, T1.15
unnamed: R30.1, T1.10
unnamed: R50.2, U1.P$12
QEA_1: IC3.62, R35.2
QEA_2: IC3.55, R58.2
QEA_3: IC3.52, R61.2
QEA_4: IC3.44, R64.2
QEB_1: IC3.63, R23.2
QEB_2: IC3.58, R57.2
QEB_3: IC3.53, R60.2
QEB_4: IC3.50, R63.2
QEI_1: IC3.61, R36.2
QEI_2: IC3.54, R59.2
QEI_3: IC3.51, R62.2
QEI_4: IC3.43, R65.2
SCK: IC3.17, IC5.8, U1.P$13
TH1: IC3.33, R21.2
TH2: IC3.28, R24.2
TH3: IC3.29, R26.2
TH4: IC3.30, R28.2
V+: J3.1, LED5.A, R3.1
VBAT_SNS: IC3.11, R3.2, R8.1
VCCIO: FB1.1, J1.3
~CS_E: IC3.14, IC5.9
~INT_E: IC3.13, IC5.4
