CouchmobileUNSW/couchmobile-electrical/couchmobile-old-couch/couch-int-rc.brd

## EAGLE design couchmobile-old-couch/couch-int-rc.brd (2019-08-26, an earlier design)

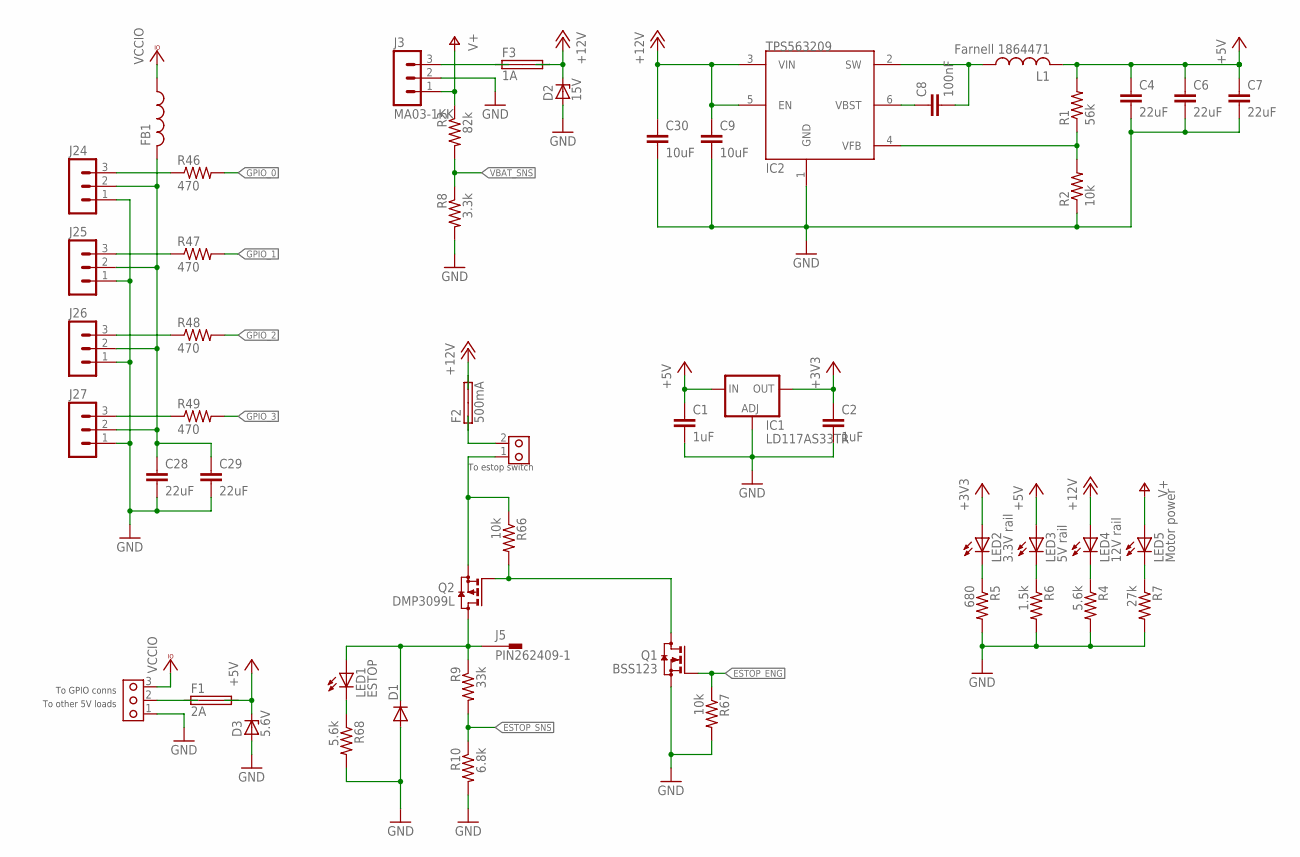
[picture p15: schematic couch-int-rc.sch, sheet 1]

Parts:
C1, C2: 1uF; C0603
C4, C6, C7, C28, C29: 22uF; C1206
C8: 100nF; C0603
C9, C30: 10uF; C1206
D1: DIODE-SMB; SMB
D2: 15V; SOD80C
D3: 5.6V; SOD80C
F1: 2A; SHK20L
F2: 500mA; SHK20L
F3: 1A; SHK20L
FB1: L-USL3216C; L3216C
IC1: LD117AS33TR; SOT223
IC2: TPS563209; SOT23-6
J1: PCBTERM3
J3: MA03-1KK; MOLEX-3
J4: PCBTERM2; PCBTERM
J5: PIN262409-1; 62409-1
J24, J25, J26, J27: MA03-1
L1: Farnell 1864471; MCSDRH73B
LED1: ESTOP; CHIPLED_0603
LED2: 3.3V rail; CHIPLED_0603
LED3: 5V rail; CHIPLED_0603
LED4: 12V rail; CHIPLED_0603
LED5: Motor power; CHIPLED_0603
Q1: BSS123; SOT23
Q2: DMP3099L; SOT23
R1: 56k; R0603
R2, R66, R67: 10k; R0603
R3: 82k; R0603
R4, R68: 5.6k; R0603
R5: 680; R0603
R6: 1.5k; R0603
R7: 27k; R0603
R8: 3.3k; R0603
R9: 33k; R0603
R10: 6.8k; R0603
R46, R47, R48, R49: 470; R0603

Connections:
12V_ESTOP: D1.C, J5.A1, J5.A2, LED1.A, Q2.3 (D), R9.1
+3V3: C2.1, IC1.4 (OUT), LED2.A; also elsewhere on the board
+5V: C1.1, C4.1, C6.1, C7.1, D3.C, F1.2A (2), F1.2B (2), IC1.3 (IN), L1.P$2 (2), LED3.A, R1.2; also elsewhere on the board
+12V: C9.1, C30.1, D2.C, F2.2A, F2.2B, F3.2A, F3.2B, IC2.3 (VIN), IC2.5 (EN), LED4.A
ESTOP_ENG: Q1.1 (G), R67.1; also elsewhere on the board
ESTOP_SNS: R9.2, R10.1; also elsewhere on the board
GND: C1.2, C2.2, C4.2, C6.2, C7.2, C9.2, C28.2, C29.2, C30.2, D1.A, D2.A, D3.A, IC1.1 (ADJ), IC2.1 (GND), J1.1, J3.2, J24.1, J25.1, J26.1, J27.1, Q1.2 (S), R2.1, R4.2, R5.2, R6.2, R7.2, R8.2, R10.2, R67.2, R68.2; also elsewhere on the board
GPIO_0: R46.2; also elsewhere on the board
GPIO_1: R47.2; also elsewhere on the board
GPIO_2: R48.2; also elsewhere on the board
GPIO_3: R49.2; also elsewhere on the board
unnamed: IC2.4 (VFB), R1.1, R2.2
unnamed: C8.2, IC2.2 (SW), L1.P$1 (1)
unnamed: F1.1A (1), F1.1B (1), J1.2
unnamed: C8.1, IC2.6 (VBST)
unnamed: LED2.C, R5.1
unnamed: LED3.C, R6.1
unnamed: LED4.C, R4.1
unnamed: LED5.C, R7.1
unnamed: F3.1A, F3.1B, J3.3
unnamed: F2.1A, F2.1B, J4.2
unnamed: Q1.3 (D), Q2.1 (G), R66.2
unnamed: C28.1, C29.1, FB1.2, J24.2, J25.2, J26.2, J27.2
unnamed: J4.1, Q2.2 (S), R66.1
unnamed: LED1.C, R68.1
unnamed: J27.3, R49.1
unnamed: J26.3, R48.1
unnamed: J25.3, R47.1
unnamed: J24.3, R46.1
V+: J3.1, LED5.A, R3.1
VBAT_SNS: R3.2, R8.1; also elsewhere on the board
VCCIO: FB1.1, J1.3

Notes on the sheet:
To other 5V loads
To estop switch
To GPIO conns

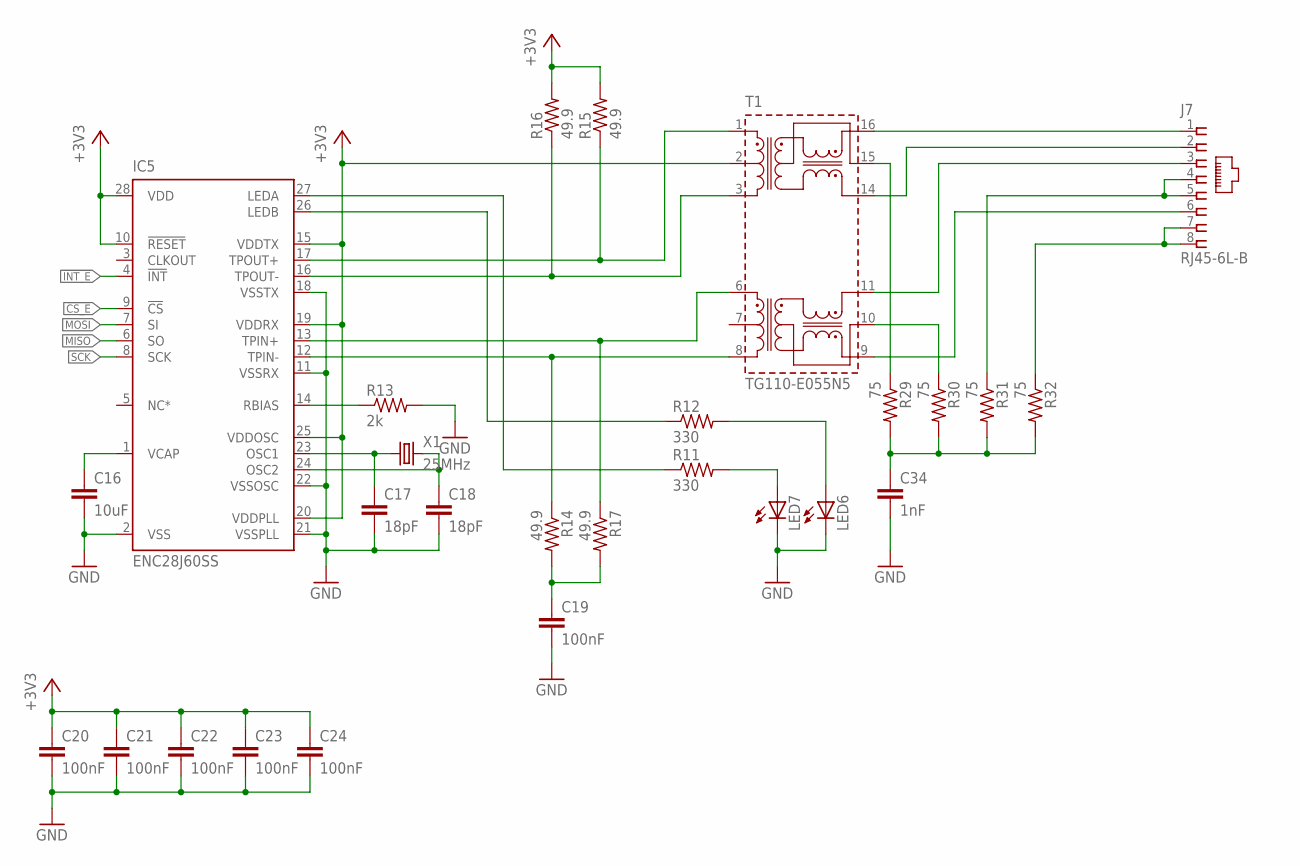
[picture p16: schematic couch-int-rc.sch, sheet 2]

Parts:
C16: 10uF; C0603
C17, C18: 18pF; C0603
C19, C20, C21, C22, C23, C24: 100nF; C0603
C34: 1nF; C0603
IC5: ENC28J60SS; SSOP-28
J7: RJ45-6L-B; RJ45-NO-SHIELD
LED6, LED7: LEDCHIP-LED0603; CHIP-LED0603
R11, R12: 330; R0603
R13: 2k; R0603
R14, R15, R16, R17: 49.9; R0603
R29, R30, R31, R32: 75; R0603
T1: TG110-E055N5; N5
X1: 25MHz; HC49/S

Connections:
!CS_E: IC5.9 (!CS); also elsewhere on the board
!INT_E: IC5.4 (!INT); also elsewhere on the board
+3V3: C20.1, C21.1, C22.1, C23.1, C24.1, IC5.10 (!RESET), IC5.15 (VDDTX), IC5.19 (VDDRX), IC5.20 (VDDPLL), IC5.25 (VDDOSC), IC5.28 (VDD), R15.2, R16.2, T1.2; also elsewhere on the board
GND: C16.2, C17.2, C18.2, C19.2, C20.2, C21.2, C22.2, C23.2, C24.2, C34.2, IC5.2 (VSS), IC5.11 (VSSRX), IC5.18 (VSSTX), IC5.21 (VSSPLL), IC5.22 (VSSOSC), LED6.C, LED7.C, R13.2; also elsewhere on the board
MISO: IC5.6 (SO); also elsewhere on the board
MOSI: IC5.7 (SI); also elsewhere on the board
unnamed: LED6.A, R12.2
unnamed: IC5.17 (TPOUT+), R15.1, T1.1
unnamed: IC5.16 (TPOUT-), R16.1, T1.3
unnamed: IC5.13 (TPIN+), R17.1, T1.6
unnamed: IC5.12 (TPIN-), R14.1, T1.8
unnamed: C16.1, IC5.1 (VCAP)
unnamed: IC5.27 (LEDA), R11.1
unnamed: IC5.26 (LEDB), R12.1
unnamed: J7.1, T1.16
unnamed: J7.4, J7.5, R31.1
unnamed: C18.1, IC5.24 (OSC2), X1.2
unnamed: C17.1, IC5.23 (OSC1), X1.1
unnamed: IC5.14 (RBIAS), R13.1
unnamed: LED7.A, R11.2
unnamed: J7.7, J7.8, R32.1
unnamed: C19.1, R14.2, R17.2
unnamed: J7.2, T1.14
unnamed: J7.3, T1.11
unnamed: J7.6, T1.9
unnamed: R29.1, T1.15
unnamed: C34.1, R29.2, R30.2, R31.2, R32.2
unnamed: R30.1, T1.10
SCK: IC5.8 (SCK); also elsewhere on the board

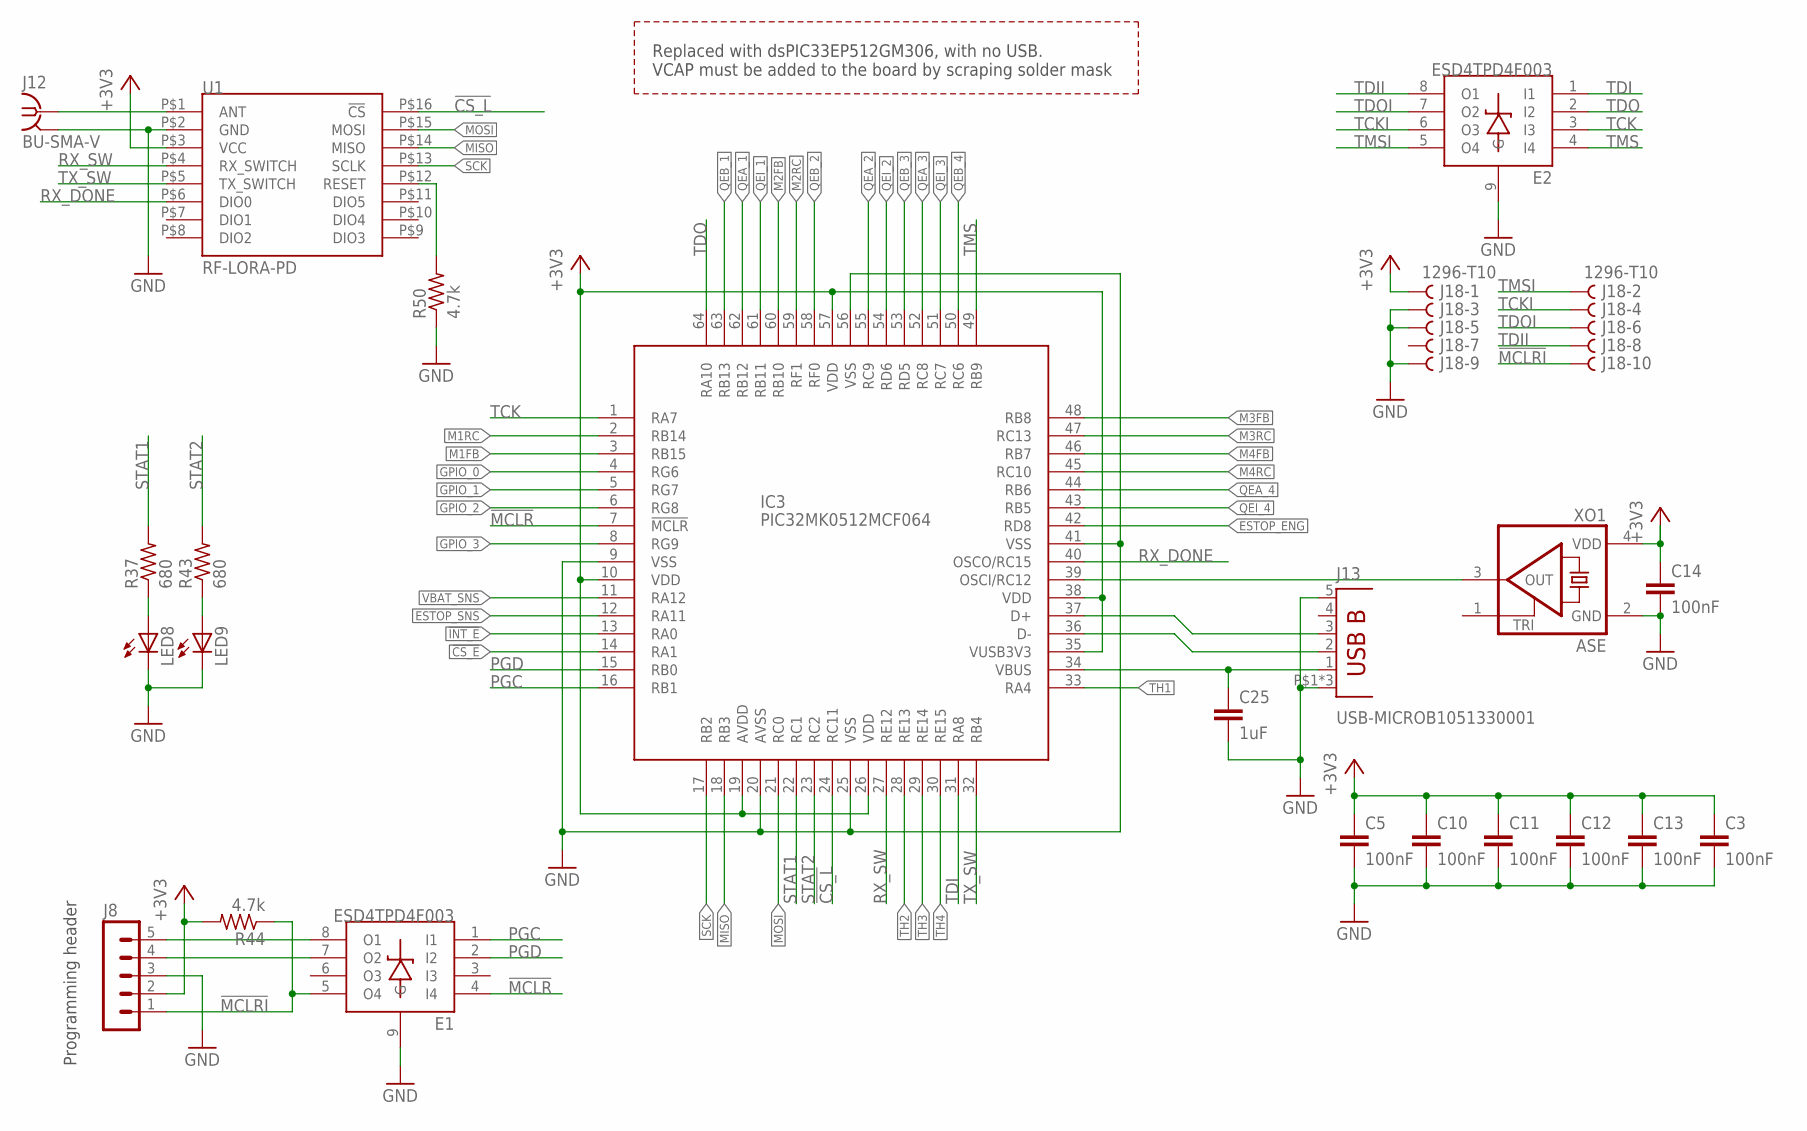
[picture p17: schematic couch-int-rc.sch, sheet 3]

Parts:
C3, C5, C10, C11, C12, C13, C14: 100nF; C0603
C25: 1uF; C0603
E1, E2: ESD4TPD4F003; WSON-8
IC3: PIC32MK0512MCF064; TQFP-64-10
J8: MA05-1
J12: BU-SMA-V
J13: USB-MICROB1051330001; 1051330001
J18: 1296-T10; 1296-10
LED8, LED9: LEDCHIP-LED0603; CHIP-LED0603
R37, R43: 680; R0603
R44, R50: 4.7k; R0603
U1: RF-LORA-PD; RF-LORA-DIP
XO1: ASE

Connections:
!CS_E: IC3.14 (RA1); also elsewhere on the board
!CS_L: IC3.24 (RC11), U1.P$16 (!CS)
!INT_E: IC3.13 (RA0); also elsewhere on the board
!MCLR: E1.4 (I4), IC3.7 (!MCLR)
!MCLRI: E1.5 (O4), J8.1, J18.10, R44.1
+3V3: C3.1, C5.1, C10.1, C11.1, C12.1, C13.1, C14.1, IC3.10 (VDD), IC3.19 (AVDD), IC3.26 (VDD), IC3.35 (VUSB3V3), IC3.38 (VDD), IC3.57 (VDD), J8.2, J18.1, R44.2, U1.P$3 (VCC), XO1.4 (VDD); also elsewhere on the board
ESTOP_ENG: IC3.42 (RD8); also elsewhere on the board
ESTOP_SNS: IC3.12 (RA11); also elsewhere on the board
GND: C3.2, C5.2, C10.2, C11.2, C12.2, C13.2, C14.2, C25.2, E1.9 (G), E2.9 (G), IC3.9 (VSS), IC3.20 (AVSS), IC3.25 (VSS), IC3.41 (VSS), IC3.56 (VSS), J8.3, J12.2, J12.3 (2), J12.4 (2), J12.5 (2), J13.5 (GND), J13.P$1 (SHIELD), J13.P$2 (SHIELD), J13.P$3 (SHIELD), J18.3, J18.5, J18.9, LED8.C, LED9.C, R50.1, U1.P$2 (GND), XO1.2 (GND); also elsewhere on the board
GPIO_0: IC3.4 (RG6); also elsewhere on the board
GPIO_1: IC3.5 (RG7); also elsewhere on the board
GPIO_2: IC3.6 (RG8); also elsewhere on the board
GPIO_3: IC3.8 (RG9); also elsewhere on the board
M1FB: IC3.3 (RB15); also elsewhere on the board
M1RC: IC3.2 (RB14); also elsewhere on the board
M2FB: IC3.60 (RB10); also elsewhere on the board
M2RC: IC3.59 (RF1); also elsewhere on the board
M3FB: IC3.48 (RB8); also elsewhere on the board
M3RC: IC3.47 (RC13); also elsewhere on the board
M4FB: IC3.46 (RB7); also elsewhere on the board
M4RC: IC3.45 (RC10); also elsewhere on the board
MISO: IC3.18 (RB3), U1.P$14 (MISO); also elsewhere on the board
MOSI: IC3.21 (RC0), U1.P$15 (MOSI); also elsewhere on the board
unnamed: IC3.39 (OSCI/RC12), XO1.3 (OUT)
unnamed: E1.8 (O1), J8.5
unnamed: E1.7 (O2), J8.4
unnamed: C25.1, IC3.34 (VBUS), J13.1 (VBUS)
unnamed: IC3.36 (D-), J13.2 (D-)
unnamed: IC3.37 (D+), J13.3 (D+)
unnamed: J12.1, U1.P$1 (ANT)
unnamed: R50.2, U1.P$12 (RESET)
unnamed: LED8.A, R37.1
unnamed: LED9.A, R43.1
PGC: E1.1 (I1), IC3.16 (RB1)
PGD: E1.2 (I2), IC3.15 (RB0)
QEA_1: IC3.62 (RB12); also elsewhere on the board
QEA_2: IC3.55 (RC9); also elsewhere on the board
QEA_3: IC3.52 (RC8); also elsewhere on the board
QEA_4: IC3.44 (RB6); also elsewhere on the board
QEB_1: IC3.63 (RB13); also elsewhere on the board
QEB_2: IC3.58 (RF0); also elsewhere on the board
QEB_3: IC3.53 (RD5); also elsewhere on the board
QEB_4: IC3.50 (RC6); also elsewhere on the board
QEI_1: IC3.61 (RB11); also elsewhere on the board
QEI_2: IC3.54 (RD6); also elsewhere on the board
QEI_3: IC3.51 (RC7); also elsewhere on the board
QEI_4: IC3.43 (RB5); also elsewhere on the board
RX_DONE: IC3.40 (OSCO/RC15), U1.P$6 (DIO0)
RX_SW: IC3.27 (RE12), U1.P$4 (RX_SWITCH)
SCK: IC3.17 (RB2), U1.P$13 (SCLK); also elsewhere on the board
STAT1: IC3.22 (RC1), R37.2
STAT2: IC3.23 (RC2), R43.2
TCK: E2.3 (I3), IC3.1 (RA7)
TCKI: E2.6 (O3), J18.4
TDI: E2.1 (I1), IC3.31 (RA8)
TDII: E2.8 (O1), J18.8
TDO: E2.2 (I2), IC3.64 (RA10)
TDOI: E2.7 (O2), J18.6
TH1: IC3.33 (RA4); also elsewhere on the board
TH2: IC3.28 (RE13); also elsewhere on the board
TH3: IC3.29 (RE14); also elsewhere on the board
TH4: IC3.30 (RE15); also elsewhere on the board
TMS: E2.4 (I4), IC3.49 (RB9)
TMSI: E2.5 (O4), J18.2
TX_SW: IC3.32 (RB4), U1.P$5 (TX_SWITCH)
VBAT_SNS: IC3.11 (RA12); also elsewhere on the board

Notes on the sheet:
Programming header
Replaced with dsPIC33EP512GM306, with no USB. VCAP must be added to the board by scraping solder mask

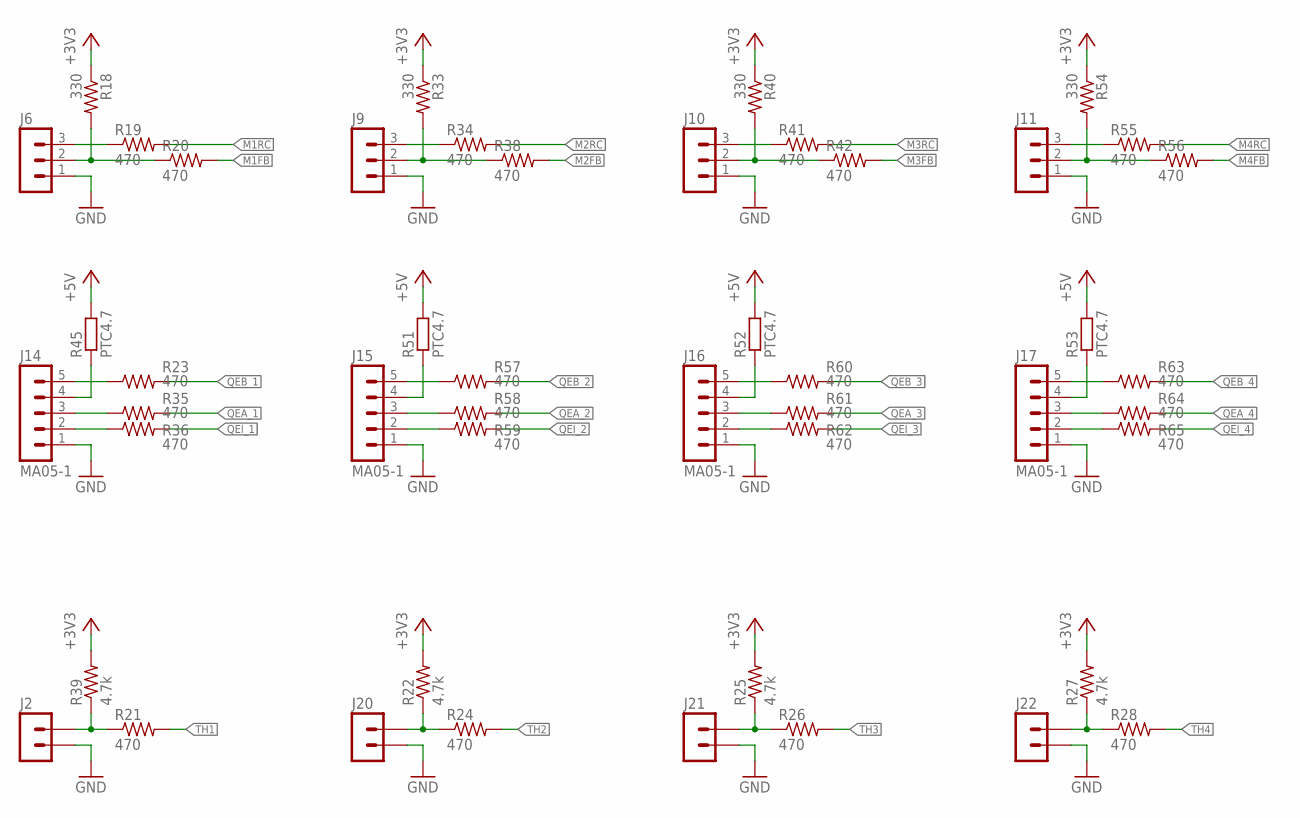
[picture p18: schematic couch-int-rc.sch, sheet 4]

Parts:
J2, J20, J21, J22: MA02-1; MOLEX-2
J6, J9, J10, J11: MA03-1
J14, J15, J16, J17: MA05-1; MOLEX-5
R18, R33, R40, R54: 330; R0603
R19, R20, R21, R23, R24, R26, R28, R34, R35, R36, R38, R41, R42, R55, R56, R57, R58, R59, R60, R61, R62, R63, R64, R65: 470; R0603
R22, R25, R27, R39: 4.7k; R0603
R45, R51, R52, R53: PTC4.7; R0603

Connections:
+3V3: R18.1, R22.2, R25.2, R27.2, R33.1, R39.2, R40.1, R54.1; also elsewhere on the board
+5V: R45.2, R51.2, R52.2, R53.2; also elsewhere on the board
GND: J2.1, J6.1, J9.1, J10.1, J11.1, J14.1, J15.1, J16.1, J17.1, J20.1, J21.1, J22.1; also elsewhere on the board
M1FB: R20.2; also elsewhere on the board
M1RC: R19.2; also elsewhere on the board
M2FB: R38.2; also elsewhere on the board
M2RC: R34.2; also elsewhere on the board
M3FB: R42.2; also elsewhere on the board
M3RC: R41.2; also elsewhere on the board
M4FB: R56.2; also elsewhere on the board
M4RC: R55.2; also elsewhere on the board
unnamed: J6.2, R18.2, R20.1
unnamed: J6.3, R19.1
unnamed: J20.2, R22.1, R24.1
unnamed: J2.2, R21.1, R39.1
unnamed: J21.2, R25.1, R26.1
unnamed: J22.2, R27.1, R28.1
unnamed: J9.2, R33.2, R38.1
unnamed: J9.3, R34.1
unnamed: J10.2, R40.2, R42.1
unnamed: J10.3, R41.1
unnamed: J11.2, R54.2, R56.1
unnamed: J11.3, R55.1
unnamed: J14.5, R23.1
unnamed: J14.3, R35.1
unnamed: J14.2, R36.1
unnamed: J15.5, R57.1
unnamed: J15.3, R58.1
unnamed: J15.2, R59.1
unnamed: J16.5, R60.1
unnamed: J16.3, R61.1
unnamed: J16.2, R62.1
unnamed: J17.5, R63.1
unnamed: J17.3, R64.1
unnamed: J17.2, R65.1
unnamed: J15.4, R51.1
unnamed: J14.4, R45.1
unnamed: J16.4, R52.1
unnamed: J17.4, R53.1
QEA_1: R35.2; also elsewhere on the board
QEA_2: R58.2; also elsewhere on the board
QEA_3: R61.2; also elsewhere on the board
QEA_4: R64.2; also elsewhere on the board
QEB_1: R23.2; also elsewhere on the board
QEB_2: R57.2; also elsewhere on the board
QEB_3: R60.2; also elsewhere on the board
QEB_4: R63.2; also elsewhere on the board
QEI_1: R36.2; also elsewhere on the board
QEI_2: R59.2; also elsewhere on the board
QEI_3: R62.2; also elsewhere on the board
QEI_4: R65.2; also elsewhere on the board
TH1: R21.2; also elsewhere on the board
TH2: R24.2; also elsewhere on the board
TH3: R26.2; also elsewhere on the board
TH4: R28.2; also elsewhere on the board

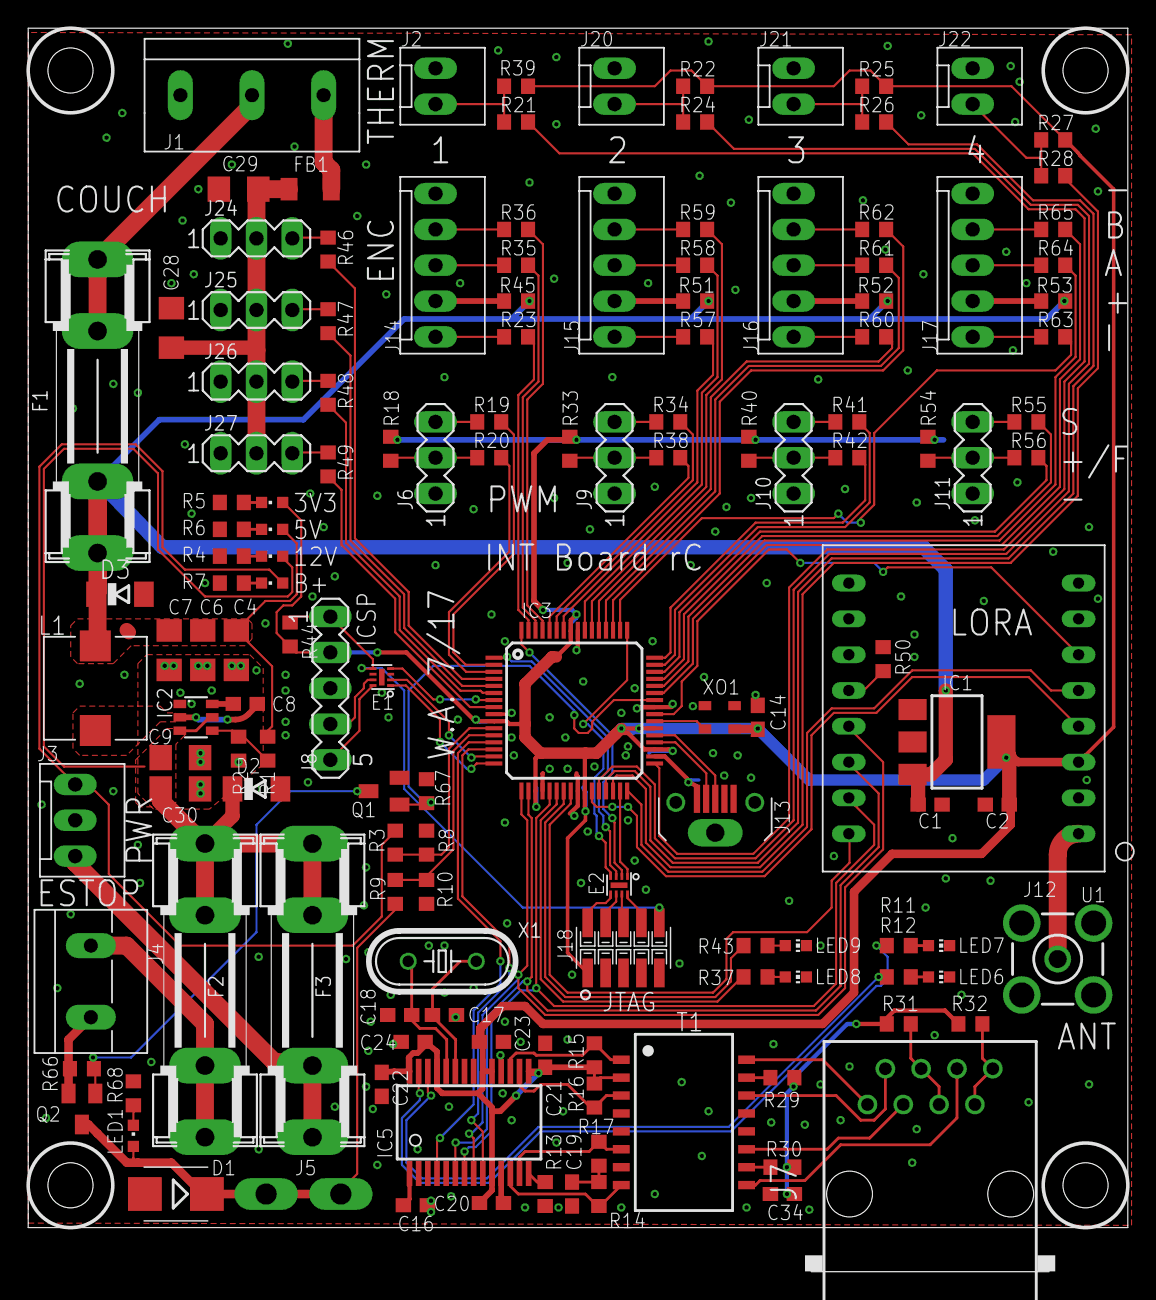
[picture p19: board couch-int-rc.brd from above]

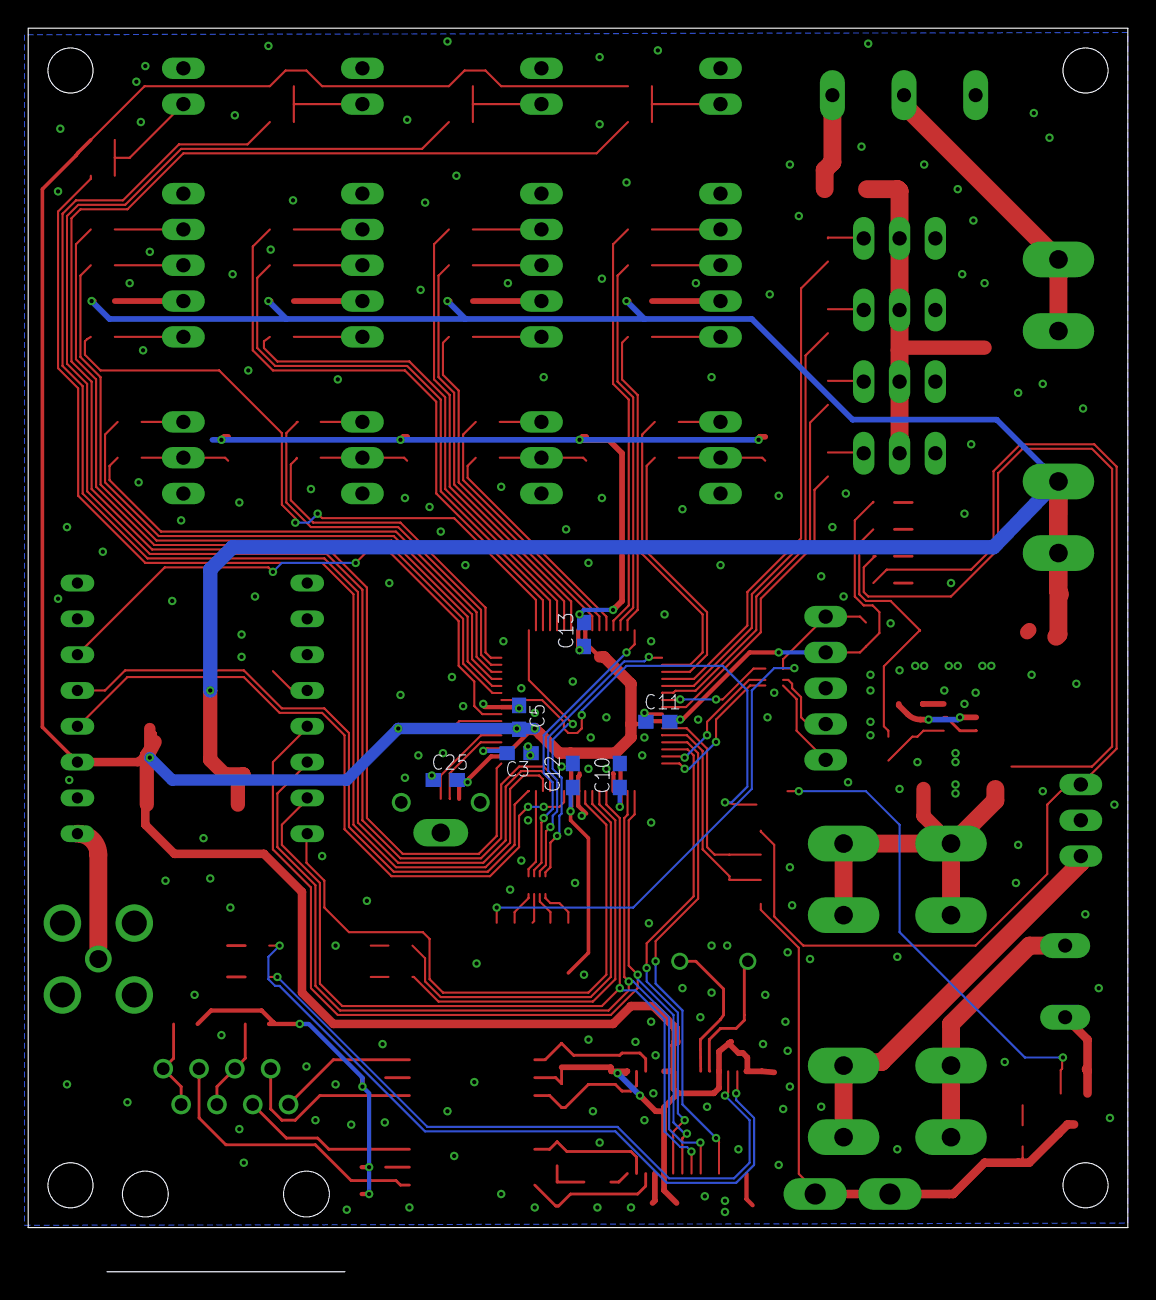
[picture p20: board couch-int-rc.brd from below]

Board: 2 copper layers, 78.0 x 88.2 mm, 150 parts (7 on the bottom side), 139 nets.
