CouchmobileUNSW/couchmobile-electrical/couchmobile-old-couch/couch-reg-rc.brd

## EAGLE design couchmobile-old-couch/couch-reg-rc.brd (2019-08-26, an earlier design)

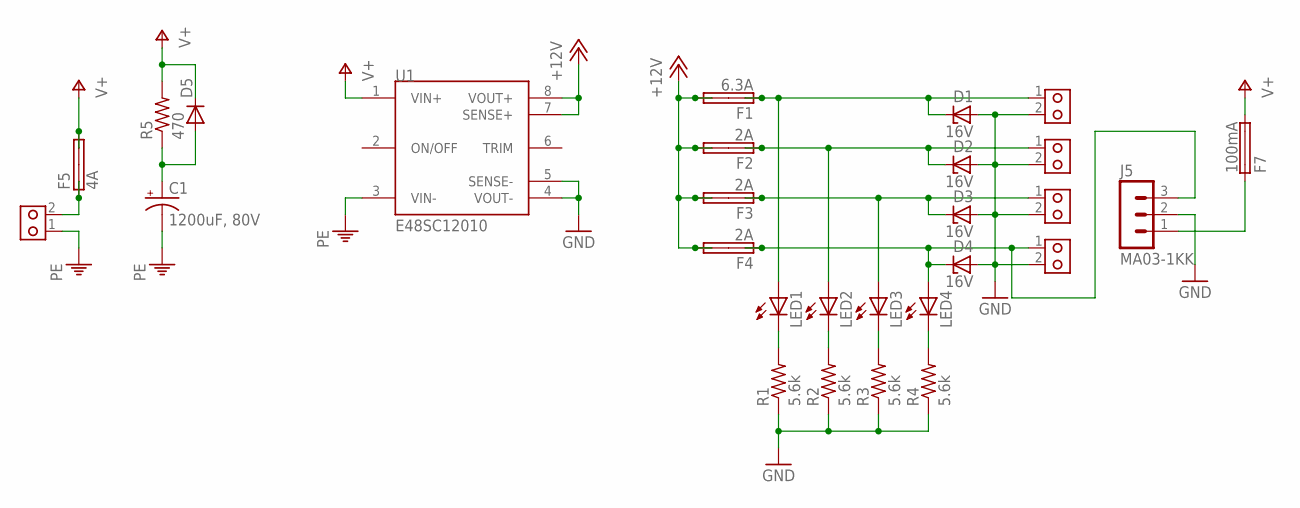
[picture p21: schematic couch-reg-rc.sch]

Parts:
C1: 1200uF, 80V; E7,5-18
D1, D2, D3, D4: 16V; C1702-15
D5: DIODE-SMB; SMB
F1: 6.3A; SHK20L
F2, F3, F4: 2A; SHK20L
F5: 4A; SHK20L
F7: 100mA; 0603
J1, J2, J3, J4, J6: PCBTERM2; PCBTERM
J5: MA03-1KK; MOLEX-3
LED1, LED2, LED3, LED4: LEDCHIPLED_0603; CHIPLED_0603
R1, R2, R3, R4: 5.6k; R0603
R5: 470; R0603
U1: E48SC12010

Connections:
+12V: F1.2A, F1.2B, F2.2A, F2.2B, F3.2A, F3.2B, F4.2A, F4.2B, U1.7 (SENSE+), U1.8 (VOUT+)
GND: D1.A, D2.A, D3.A, D4.A, J1.2, J2.2, J3.2, J4.2, J5.2, R1.1, R2.1, R3.1, R4.1, U1.4 (VOUT-), U1.5 (SENSE-)
unnamed: C1.+, D5.A, R5.1
unnamed: D4.C, F4.1A, F4.1B, J4.1, J5.3, LED4.A
unnamed: D1.C, F1.1A, F1.1B, J1.1, LED1.A
unnamed: D2.C, F2.1A, F2.1B, J2.1, LED2.A
unnamed: D3.C, F3.1A, F3.1B, J3.1, LED3.A
unnamed: F7.1, J5.1
unnamed: LED1.C, R1.2
unnamed: LED2.C, R2.2
unnamed: LED3.C, R3.2
unnamed: LED4.C, R4.2
unnamed: F5.1A, F5.1B, J6.2
PE: C1.-, J6.1, U1.3 (VIN-)
V+: D5.C, F5.2A, F5.2B, F7.2, R5.2, U1.1 (VIN+)

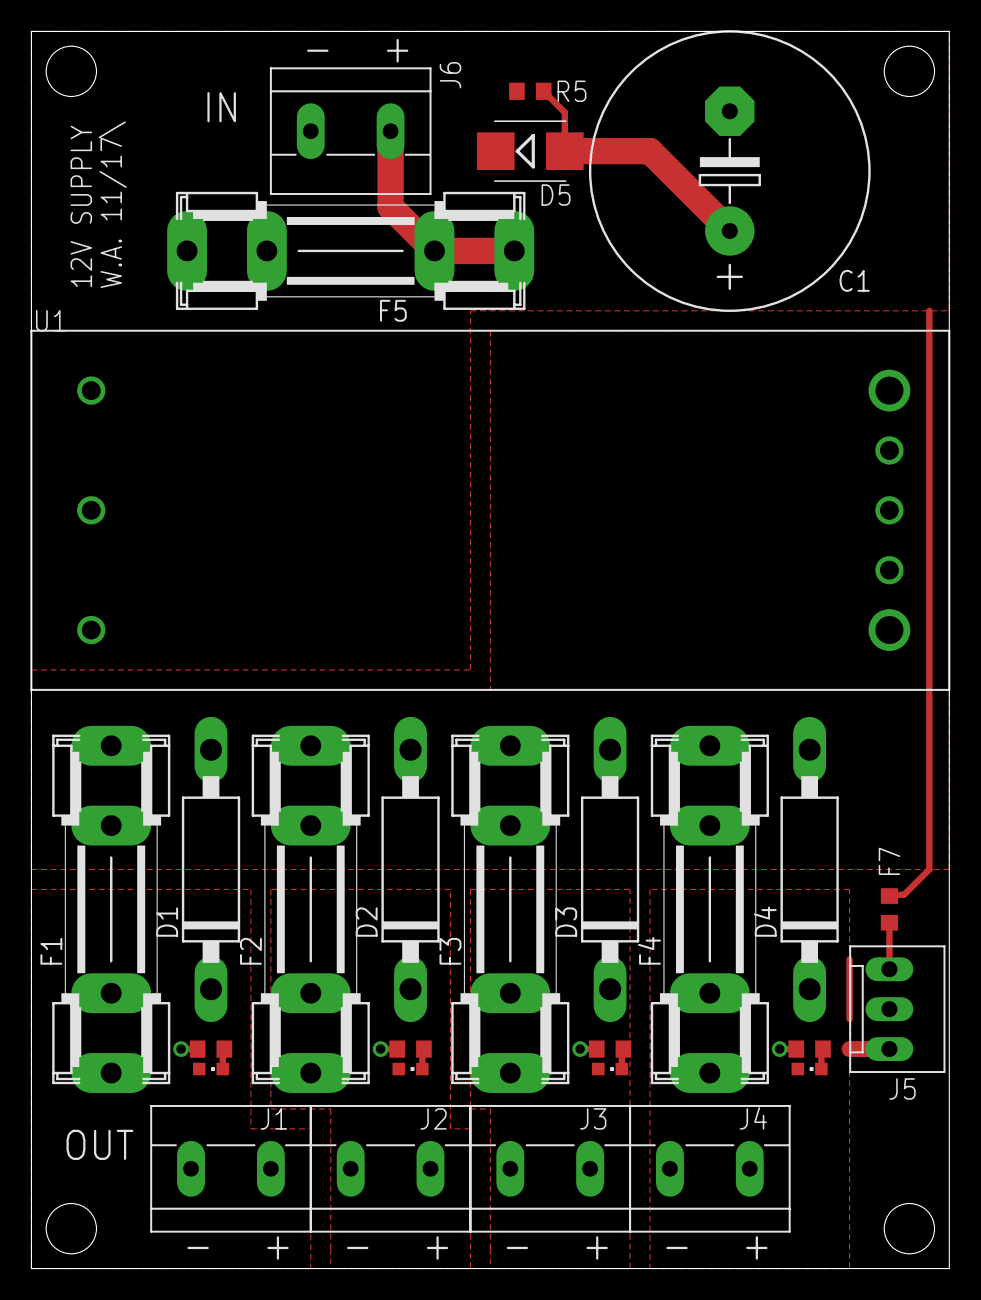
[picture p22: board couch-reg-rc.brd from above]

Board: 2 copper layers, 58.4 x 78.7 mm, 28 parts (0 on the bottom side), 15 nets.
