CouchmobileUNSW/couchmobile-electrical/couchmobile-old-couch/couch-pwr-rb.brd

## EAGLE design couchmobile-old-couch/couch-pwr-rb.brd (continued)

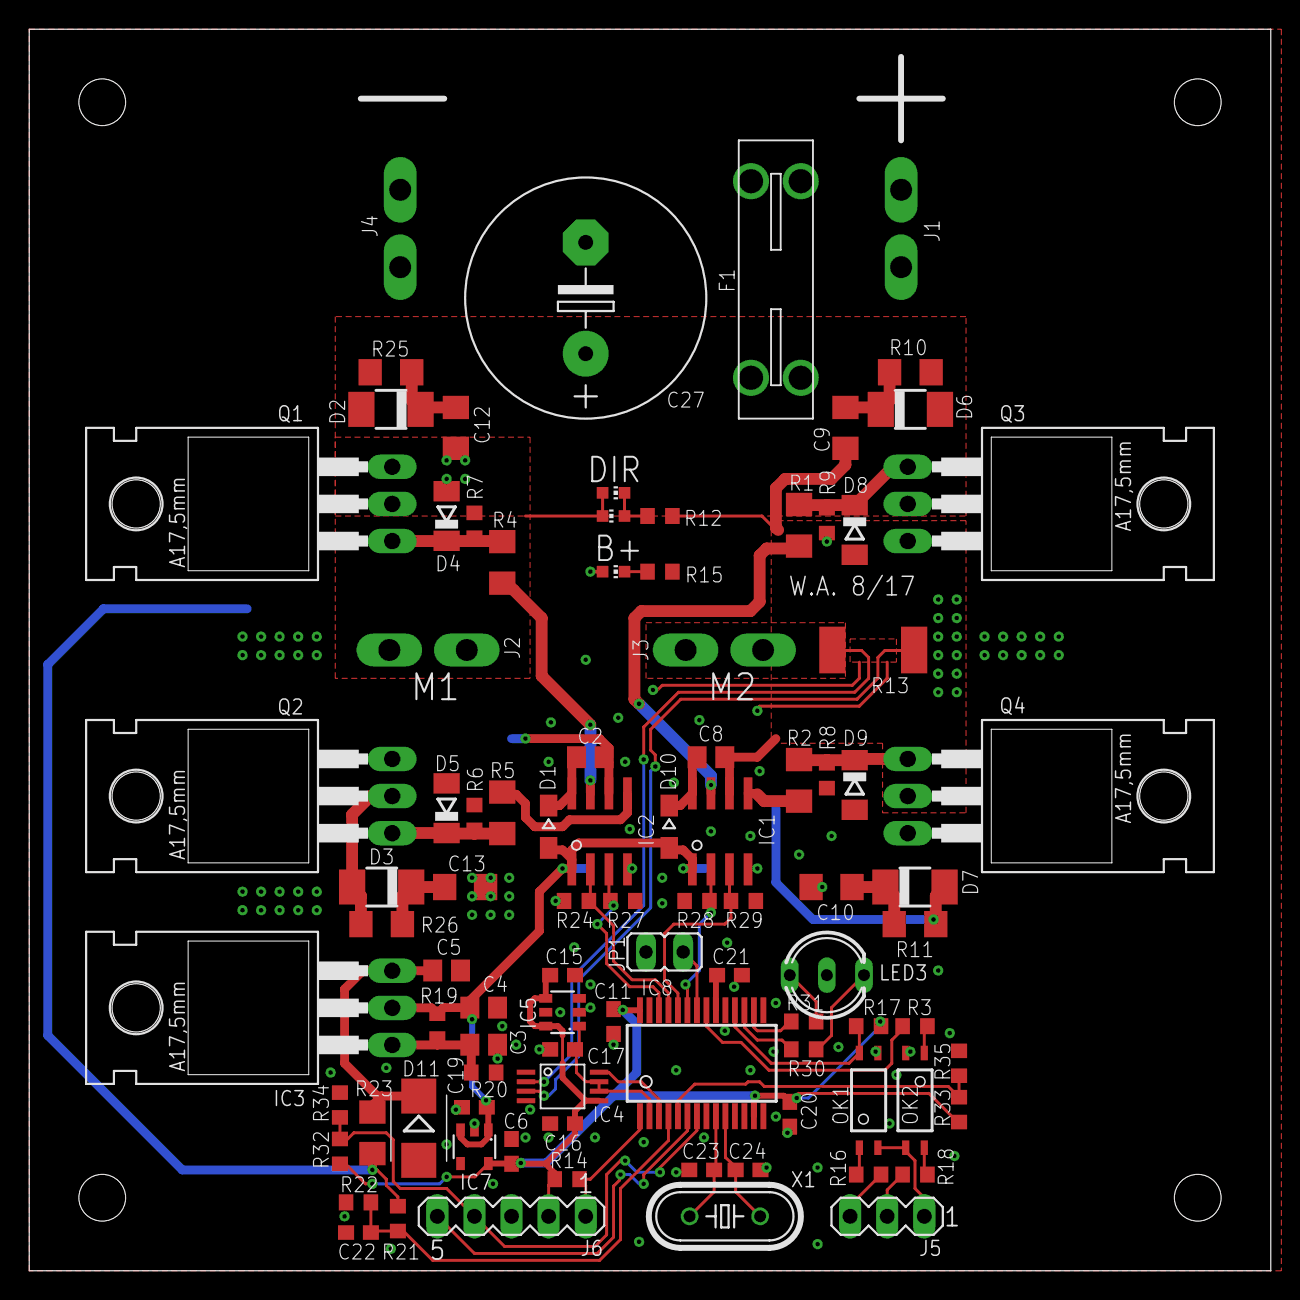
[picture p24: board couch-pwr-rb.brd from above]

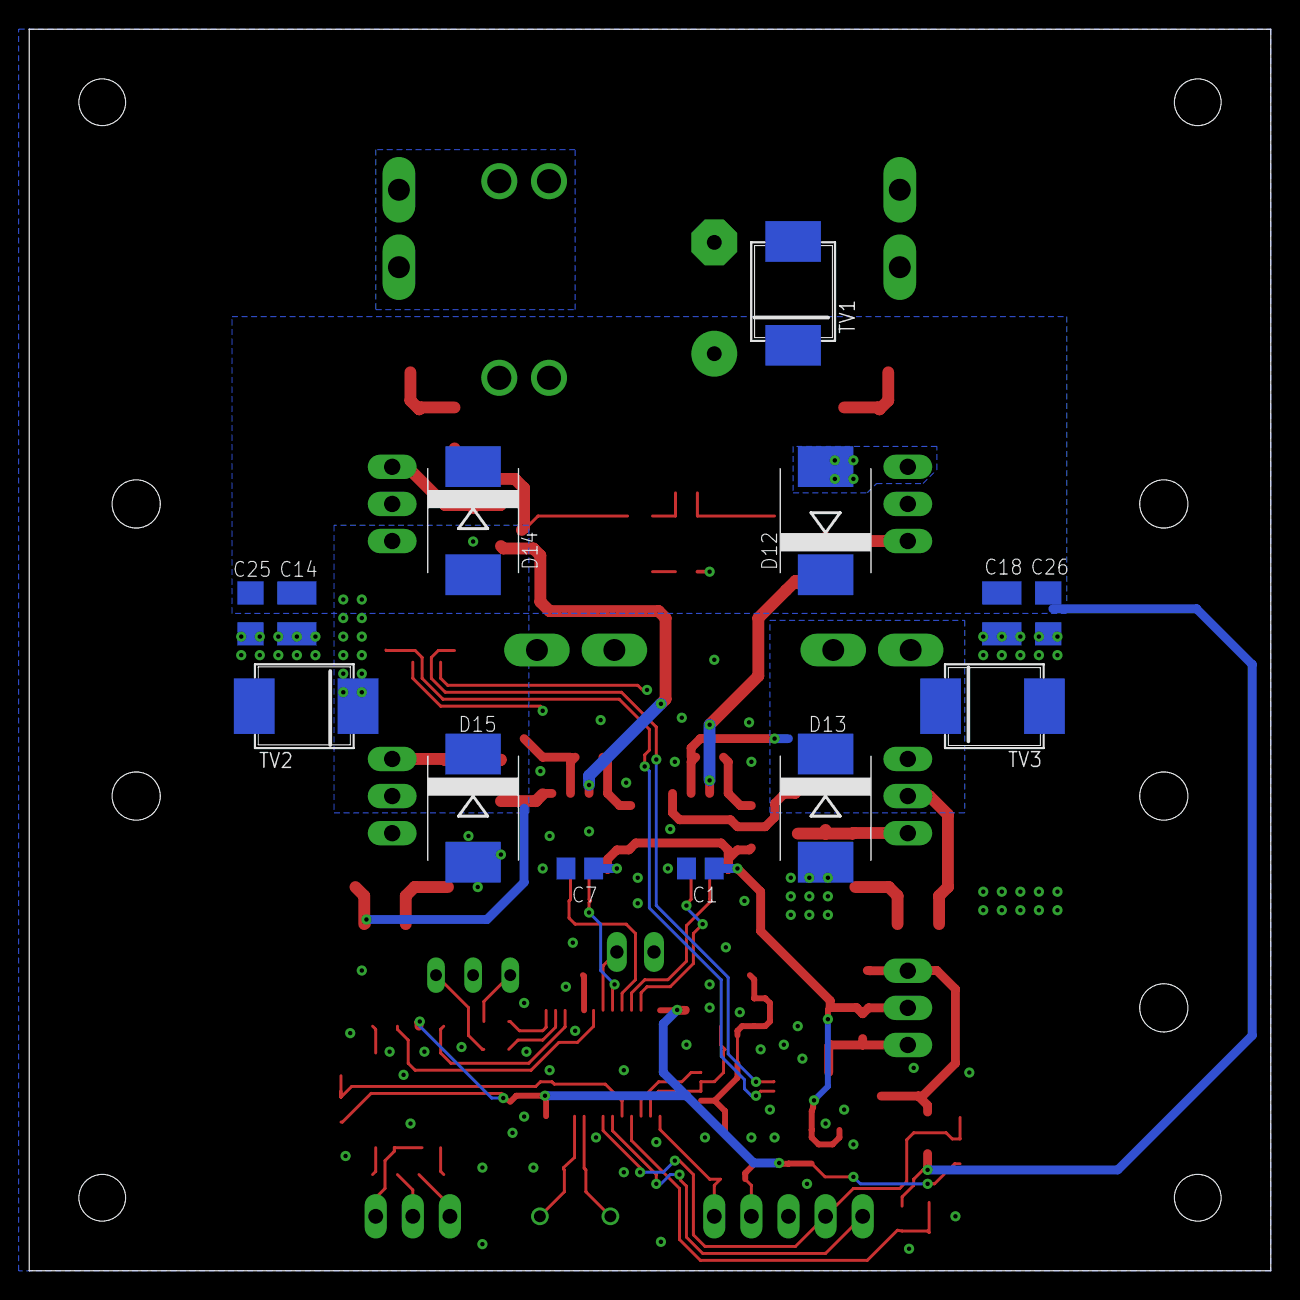
[picture p25: board couch-pwr-rb.brd from below]

Board: 2 copper layers, 85.0 x 85.0 mm, 106 parts (13 on the bottom side), 53 nets.
