CouchmobileUNSW/couchmobile-electrical/(commit log)

2019-08-04 First commit. Sending up almost finished schematic of control module.
    [couchmobile-electrical.kicad_pcb, couchmobile-electrical.sch, couchmobile-ultrasonic.kicad_pcb, couchmobile-ultrasonic.sch]
2019-08-04 Finished nano gpio
    [couchmobile-electrical.sch]
2019-08-05 Finished wiring up schematic; DRC passed. ALso added in the AND gates
    [couchmobile-electrical.sch]
2019-08-05 Laid out the LEDs and switches
2019-08-06 Made and added so8 package for pfet
    [couchmobile-electrical.kicad_pcb, couchmobile-electrical.sch]
2019-08-06 Changed solder to mask clearance to 0.05mm. Wired up half the gpio for nano
    [couchmobile-electrical.kicad_pcb]
2019-08-06 Wired up a lot of the busses.
    [couchmobile-electrical.kicad_pcb]
2019-08-06 Added 5v to 3.3v line converters.
    [couchmobile-electrical.kicad_pcb, couchmobile-electrical.sch]
2019-08-07 Laid out most lines except ground
    [couchmobile-electrical.kicad_pcb]
2019-08-07 Poured ground and did DRC. Fixed all markers.
    [couchmobile-electrical.kicad_pcb]
2019-08-07 Changed some resistor values. Generated BOM.
    [couchmobile-electrical.kicad_pcb, couchmobile-electrical.sch]
2019-08-26 Finished rev1 of board
    [couch-int-rc.brd, couch-int-rc.csv.xlsx, couch-int-rc.kicad_pcb, couch-int-rc.sch, couch-int-rc_1.sch, couch-int-rc_2.sch, couch-int-rc_3.sch, couch-int-rc_4.sch]
2019-08-26 Added in label to control panel
    [couchmobile-electrical.kicad_pcb, couchmobile-electrical.sch]
2019-08-27 Adding the couch control panel
    [control pad.kicad_pcb, control pad.sch]
2019-08-27 finished v0 of control pad pcb
    [control pad.kicad_pcb, control pad.sch]
2019-08-29 Updated labels on pcb revision 3
    [control pad.kicad_pcb]
